AkazeX/GEM/999_Präsentation/Bilder v. präsentation/10a-5-25v--dual-channel-dc-motor-driver-5-large.jpg

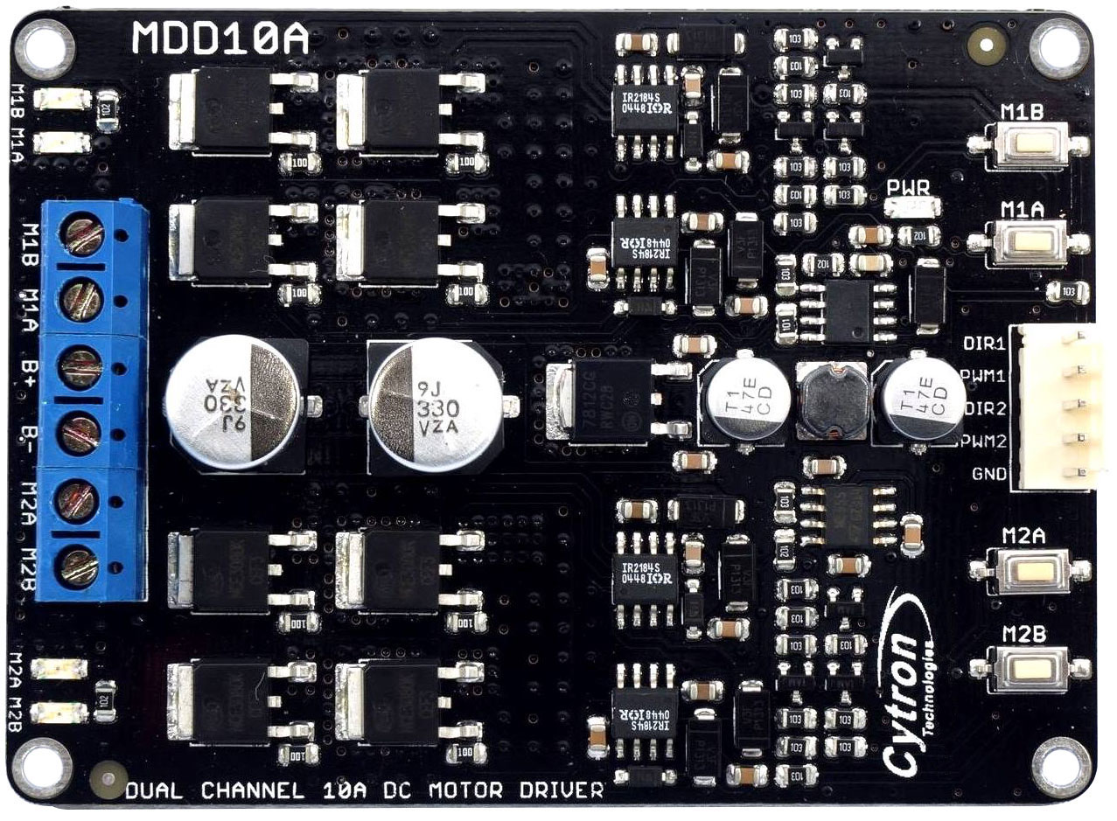
999_Präsentation/Bilder v. präsentation/10a-5-25v--dual-channel-dc-motor-driver-5-large.jpg
