AkazeX/GEM/999_Präsentation/Bilder v. präsentation/Display.jpg

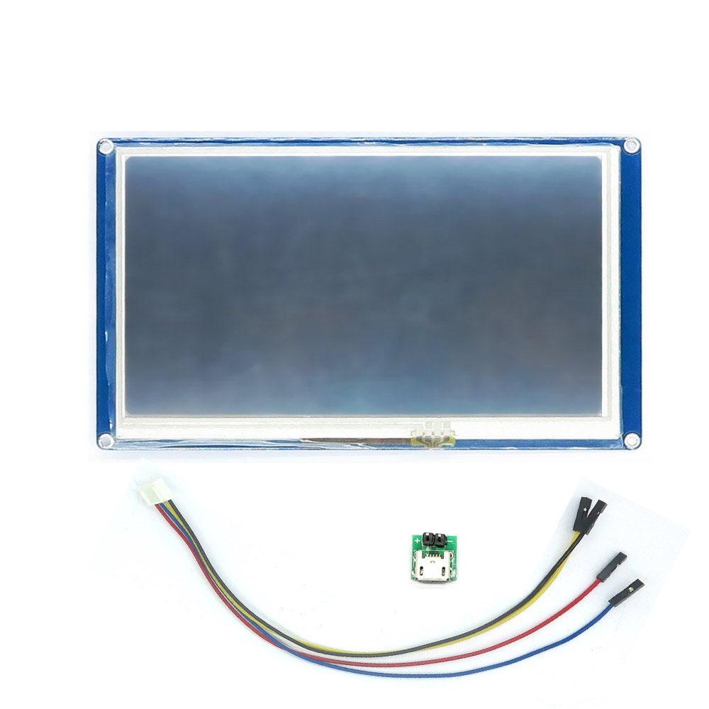
999_Präsentation/Bilder v. präsentation/Display.jpg
