AkazeX/GEM/Plakat 2.docx

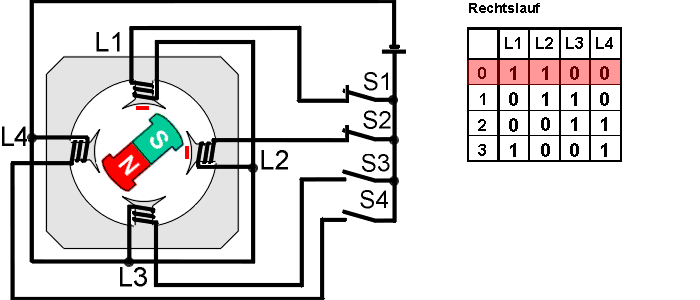
[picture p3: figure]
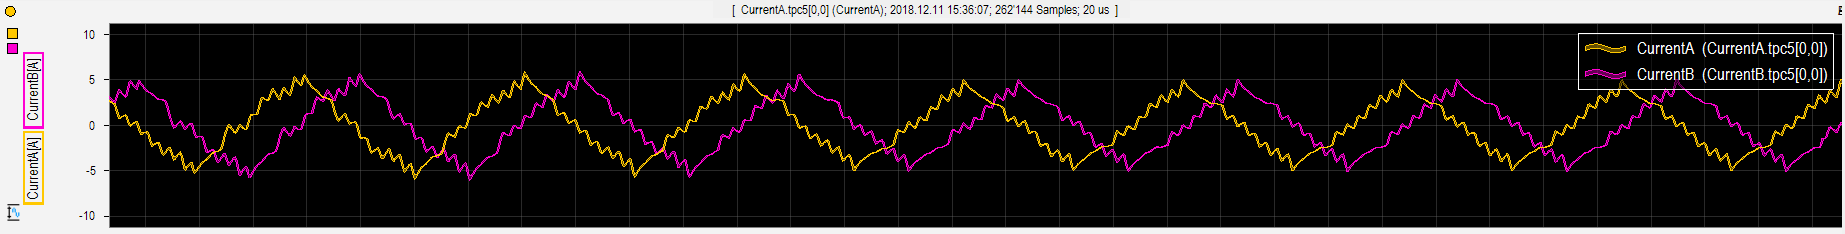
[picture p4: figure]
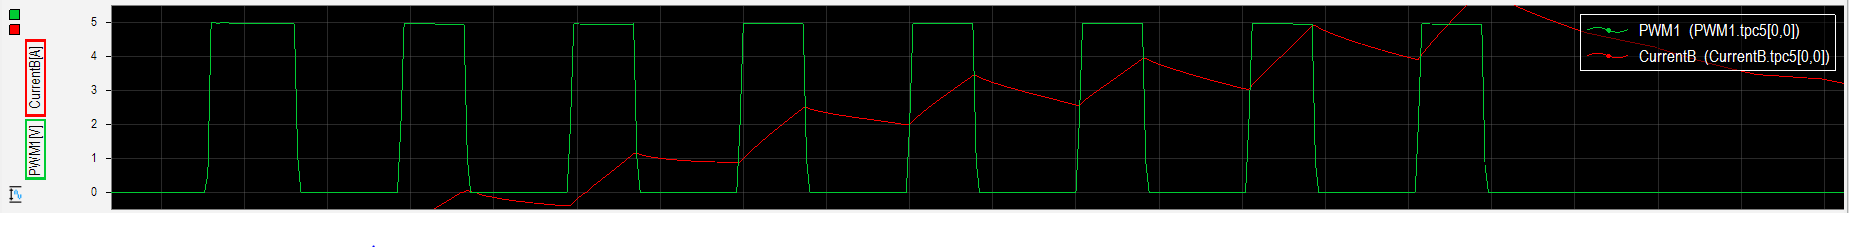
[picture p5: figure]

Ansteuerungsfolge Motor

Motorströme

PWM-Ansteuerung
