AkazeX/GEM/Plakat Software.docx

Getränke-Einschenk-Maschine

Grafcet

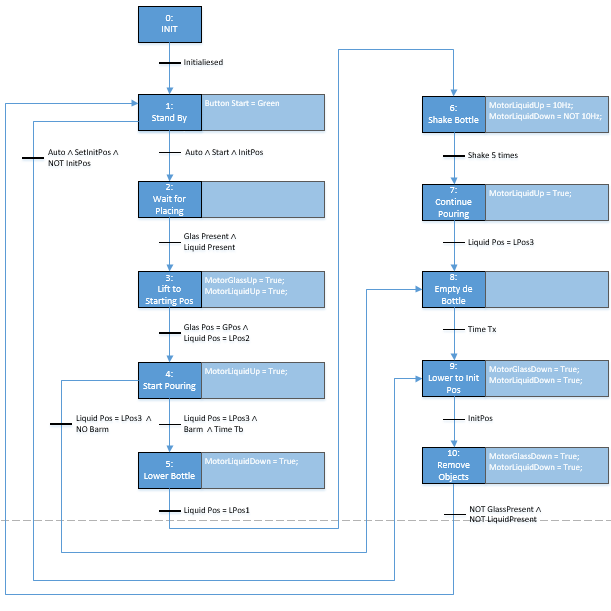
[picture p6: figure]

Display

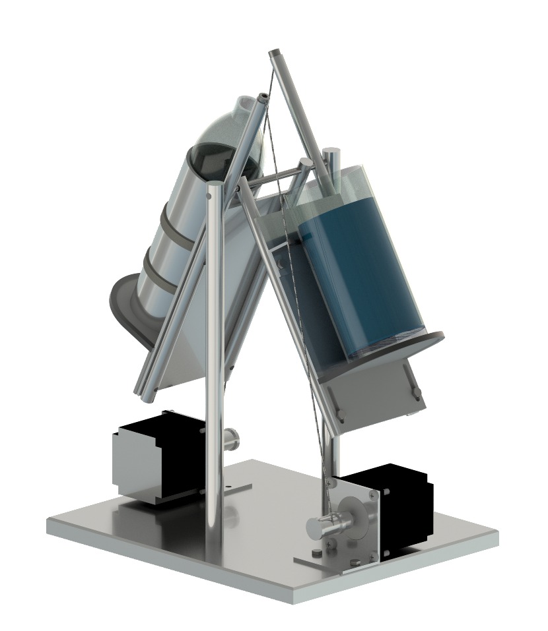
[picture p7: figure]
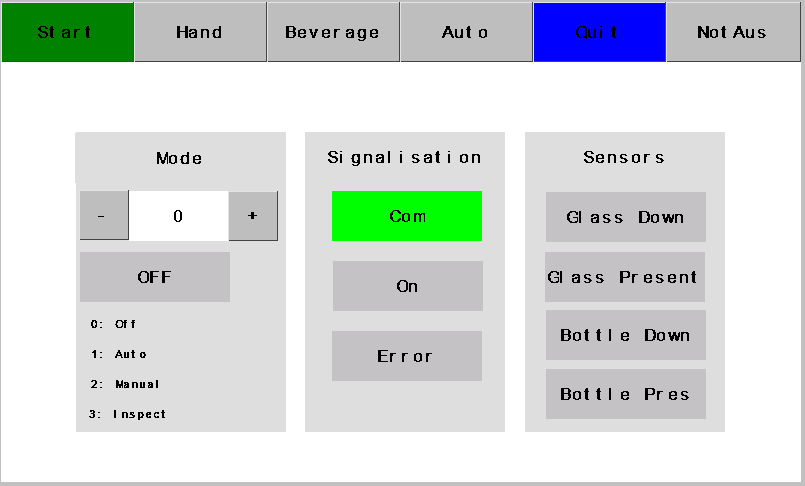
[picture p8: figure]
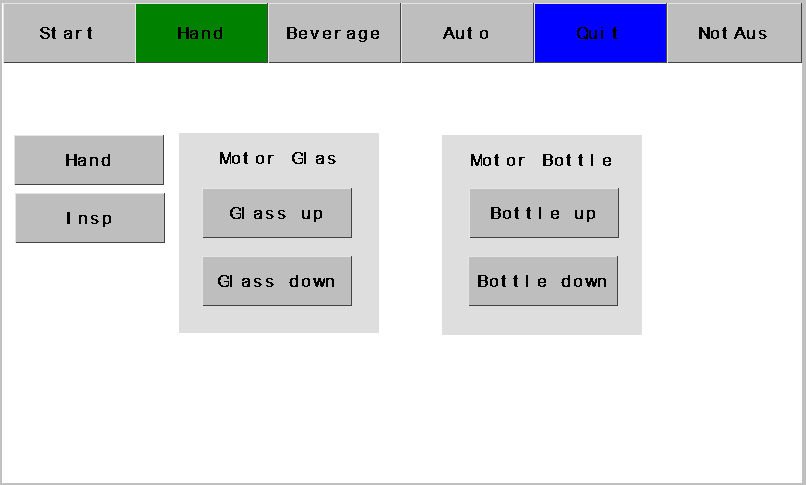
[picture p9: figure]
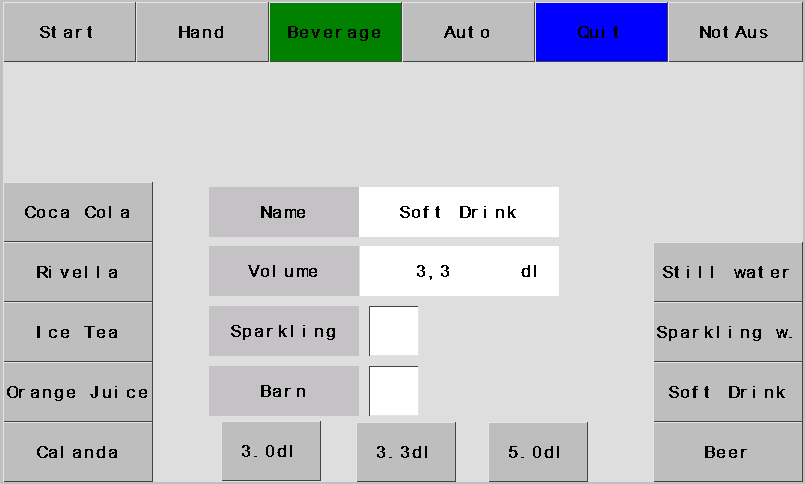
[picture p10: figure]

Kommunikation

Programm Ablauf

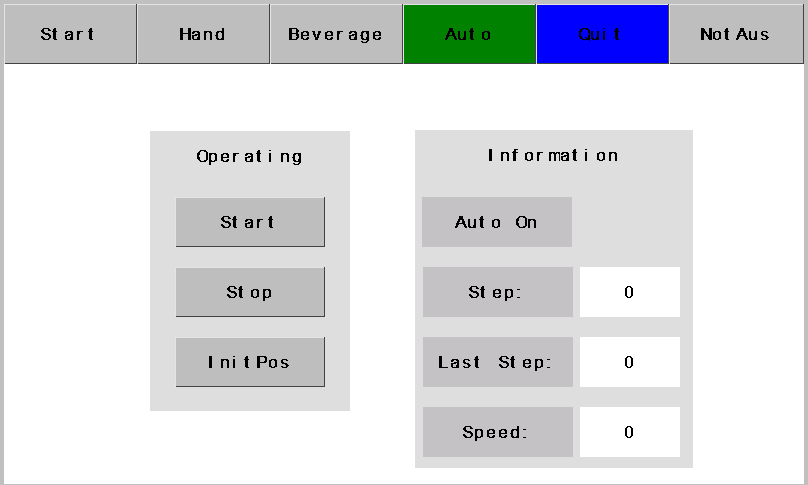
[picture p11: figure]
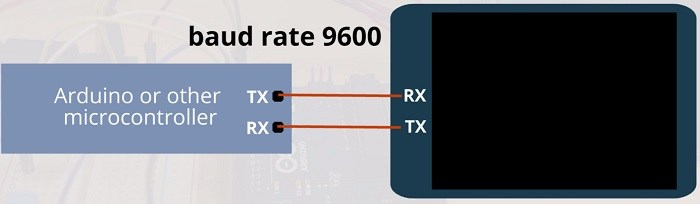
[picture p12: figure]
Image result for arduino zu nextion display
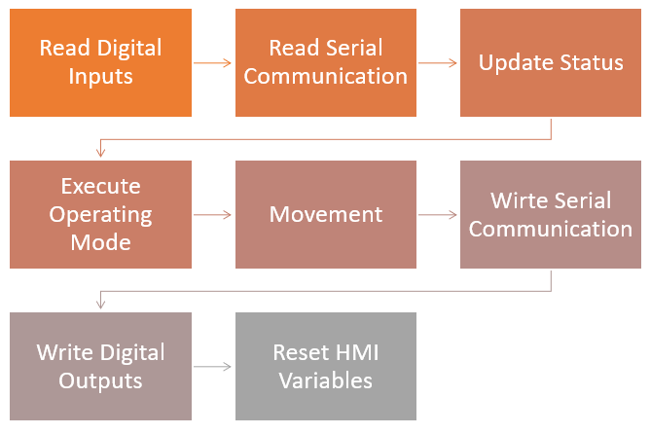
[picture p13: figure]
