AkazeX/GEM/40_Arbeitjournal/Arbeitsjournal_2018_10_31.docx

Namen: | Luca Schäfli, Nico Müller, Marc Hochuli | Datum: | 31.10.2018

Arbeit | Zeit (h)
Luca: - Start mit Programmstruktur - Einlesen in Arduino Umgebung - State machine / Grafcet | 2
Nico: - CAD zeichnen 50% | 2
Marc: - Start mit Programmstruktur - Einlesen in Arduino Umgebung | 2
Schwierigkeiten: - Kein

U:\AUT\Berufsbildung\Lernjournal\Lernjournal_xxx_KWYY_JJJJ.doc/Adrian Bärtschi/15.02.2010 Seite 2/2

\\swisslog.net\data-02\share-03\02_Realisation\02_Aut\Berufsbildung\99_Arbeitsunterlagen_mbr\IPA\Projektunterlagen\Arbeitsjournale\Arbeitsjournal_mbr_2018_Feb_26.docx/Marc Braun/28.11.2018 Seite 1/1

Lernjournal SWISSLOG
