AkazeX/GEM/10_Pflichtenheft/Links.rtf

Schrittmotoren:

https://www.distrelec.ch/de/schrittmotor-nm-65-mm-trinamic-qsh6018-65-28-210/p/15422354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

Motordriver Board:

https://www.robotshop.com/en/cytron-10a-5-30v-dual-channel-dc-motor-driver.html

Arduino:

https://www.distrelec.ch/de/microcontroller-board-mega2560-r3-arduino-a000067/p/11038920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
