AkazeX/GEM/999_Präsentation/PPP/GEM.pptx

## GEM

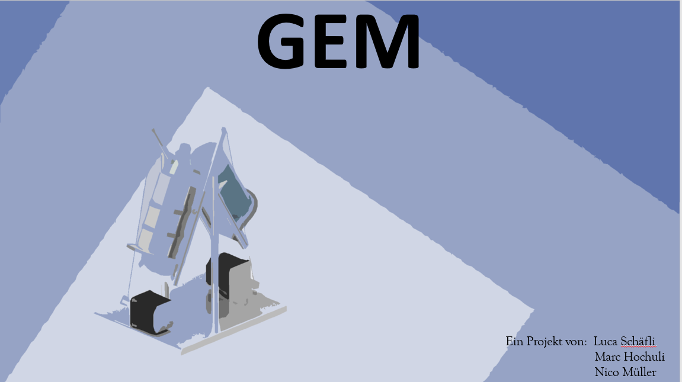
[picture p29: figure]

Ein Projekt von: Luca Schäfli
Marc Hochuli
Nico Müller

Notes: Ein Projekt von: Luca Schäfli
Marc Hochuli
Nico Müller

## Content

- Timetable
- CAD and mechanical components
- Schematics and electrical components
- Stepper motors
- Software
- Gem in Action
- Final statement

## Timetable

## CAD and mechanical components

## Schematics and electrical components

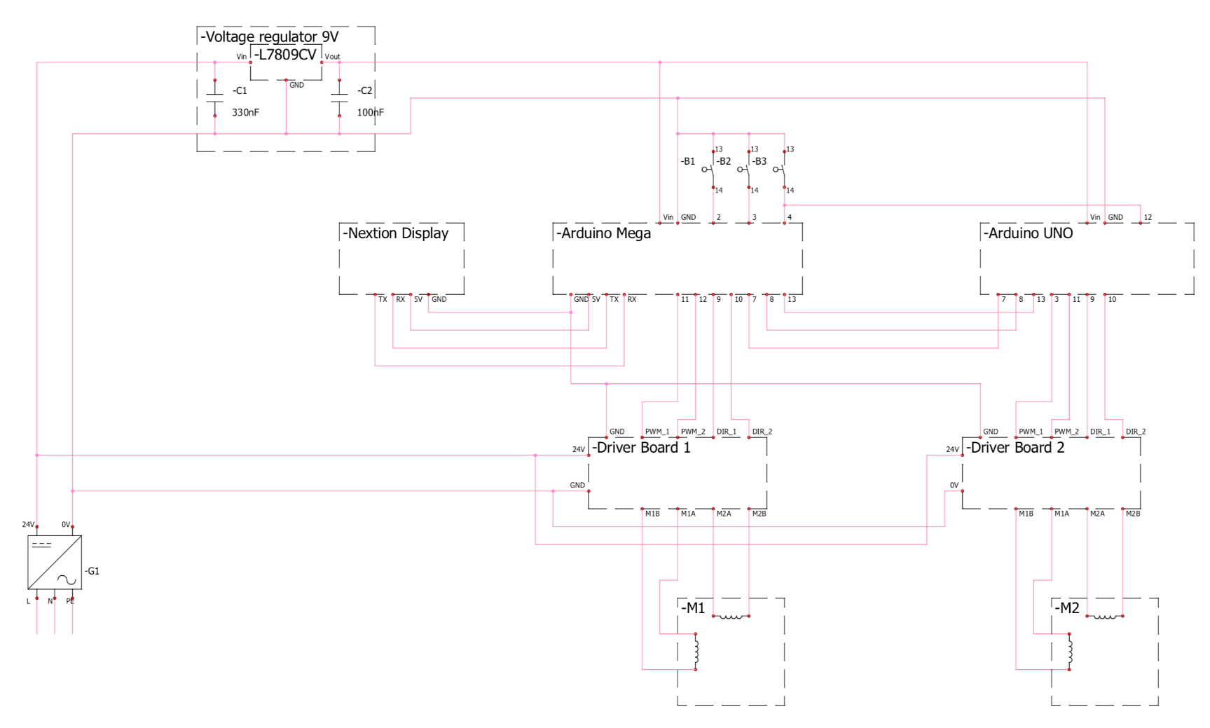
[picture p30: figure]

## Schematics and electrical components

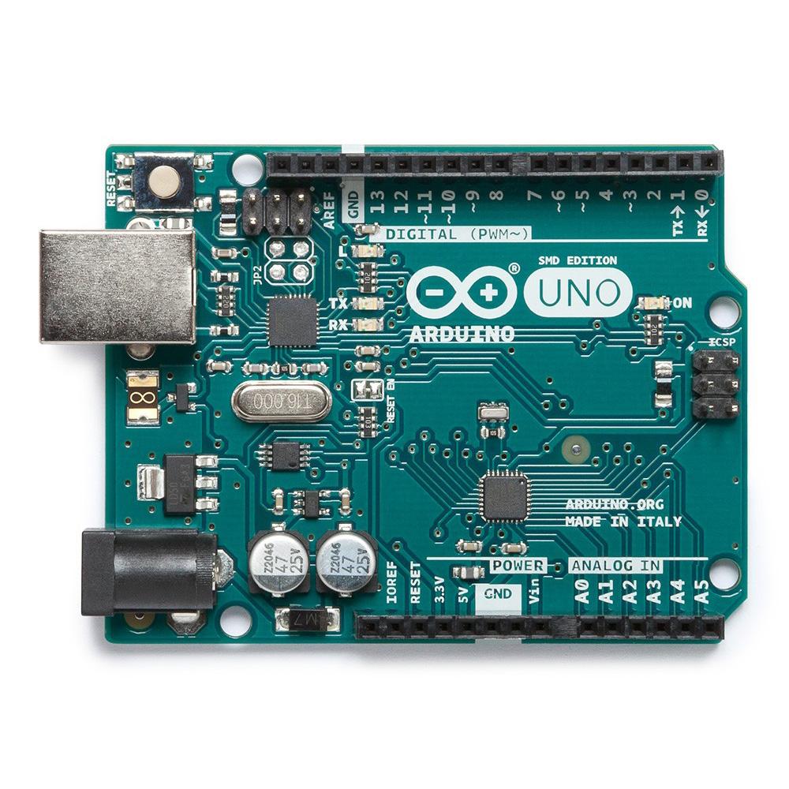
[picture p31: figure]
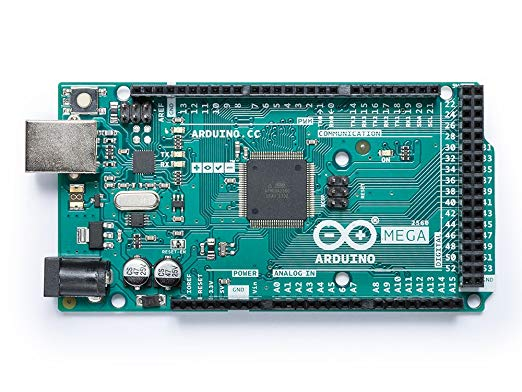
[picture p32: figure]
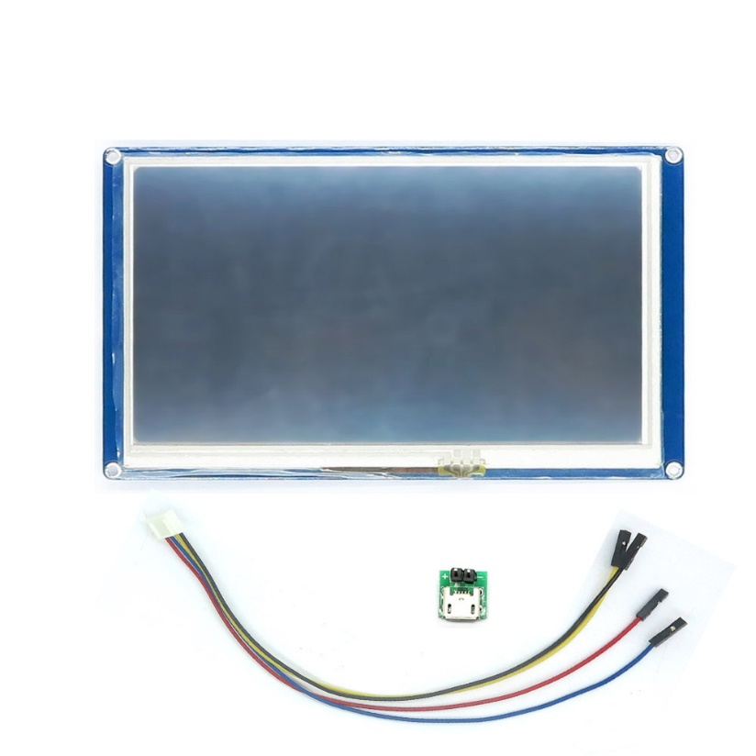
[picture p33: figure]

## Schematics and electrical components

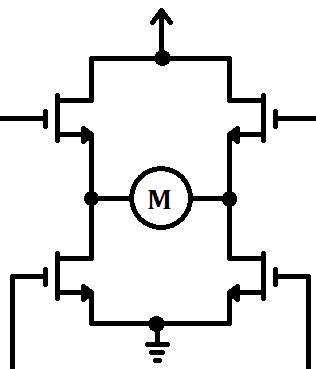
[picture p34: figure]

## Stepper motors

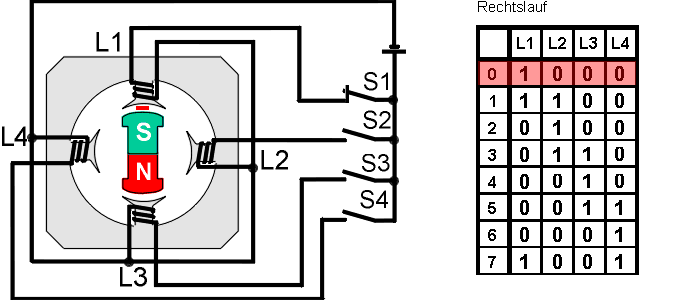
[picture p35: figure]
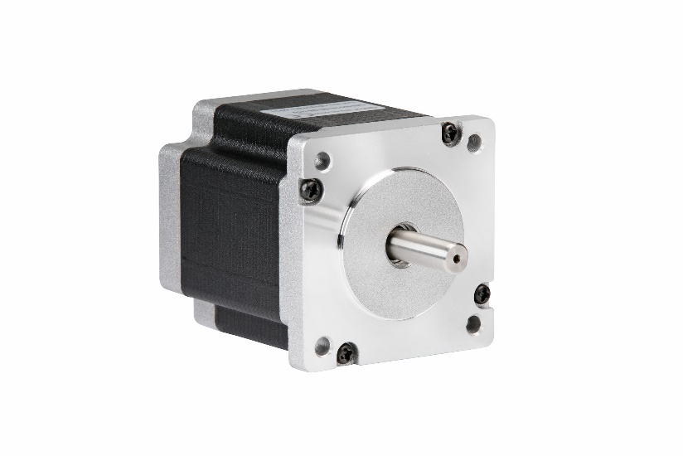
[picture p36: figure]

## Stepper motors

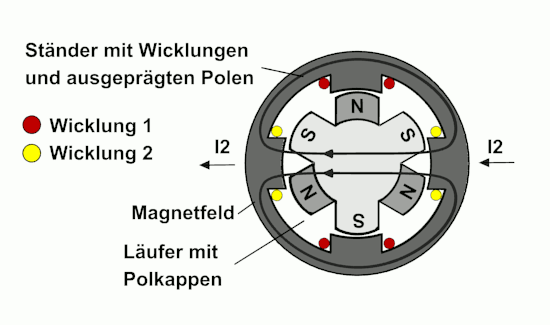
[picture p37: figure]

## Stepper motors

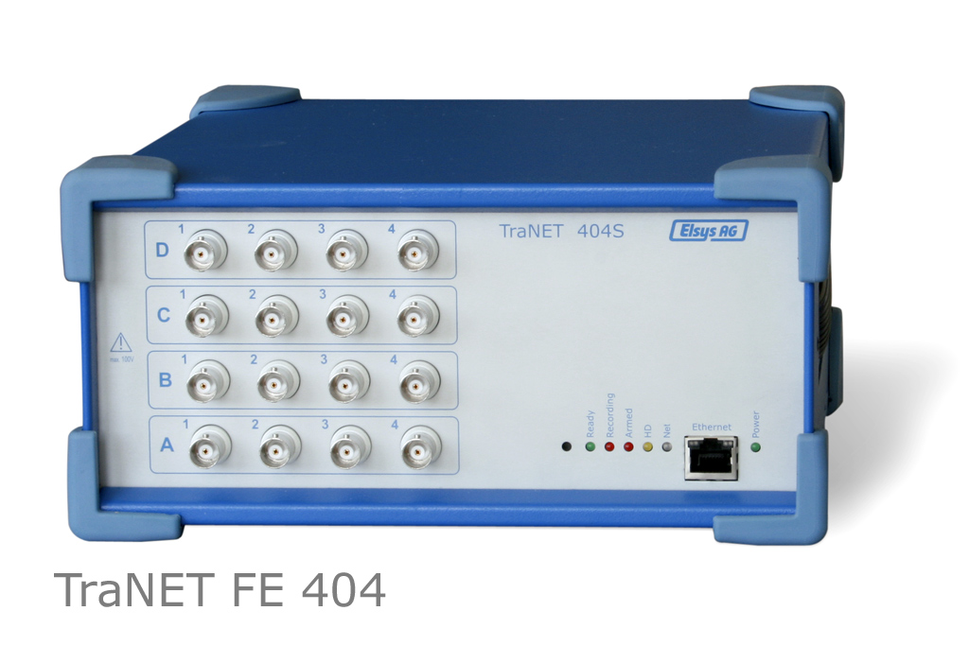
[picture p38: figure]

## Development Environment

- Arduino

- Variables Definition
- Keywords
- Void setup
- Void loop
- Statements
- {}

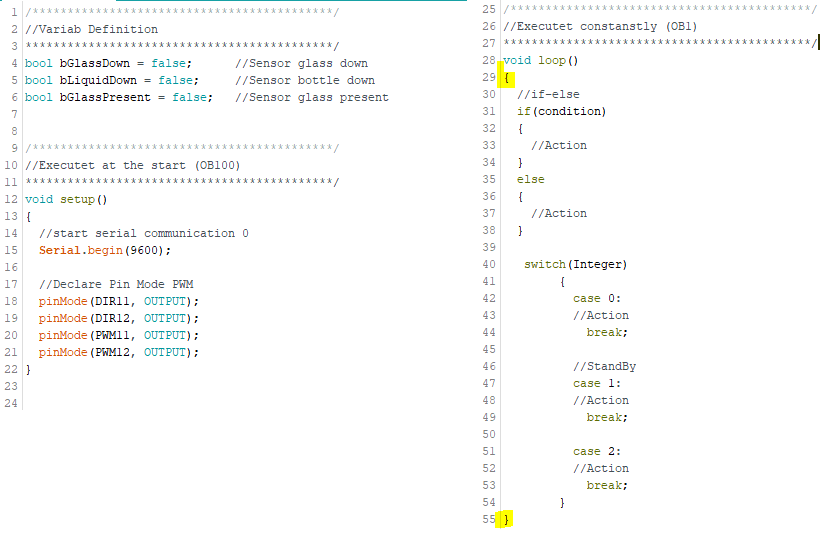
[picture p39: figure]

## Development Environment

Nextion Editor

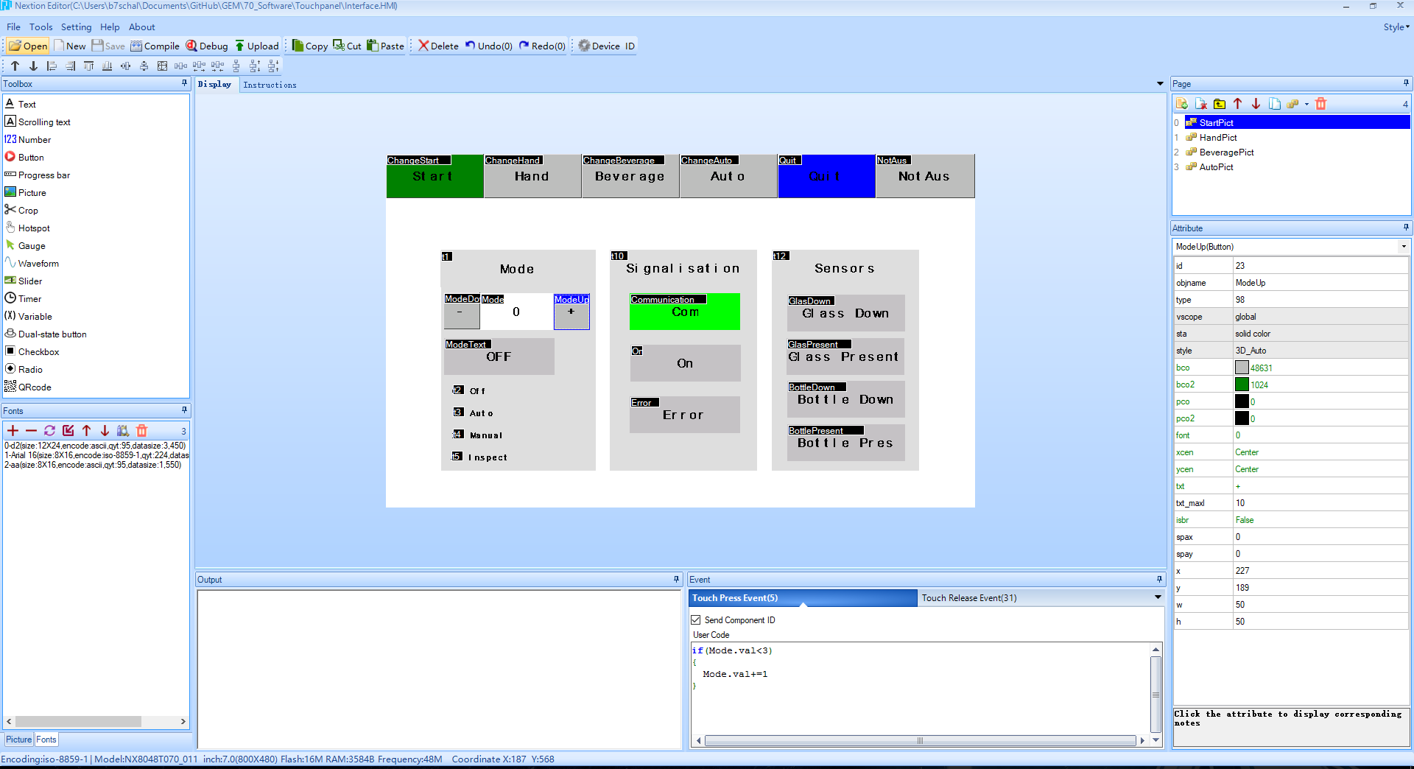
[picture p40: figure]

## Software - Structure

Read Digital Inputs
Read Serial Communication
Update Status
Execute Operating Mode
Movement
Wirte Serial Communication
Write Digital Outputs
Reset HMI Variables

## Software - Operating Modes

Operating Mode
Off
Auto
Hand
Insp

## Software – Grafcet

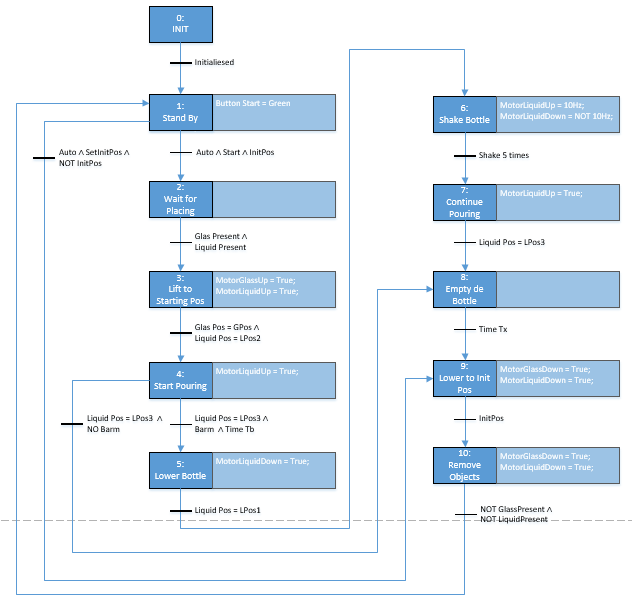
[picture p41: figure]
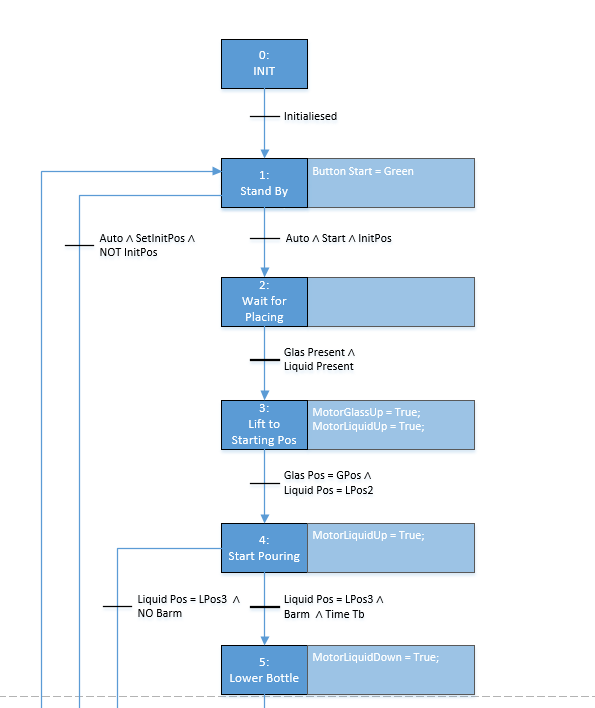
[picture p42: figure]
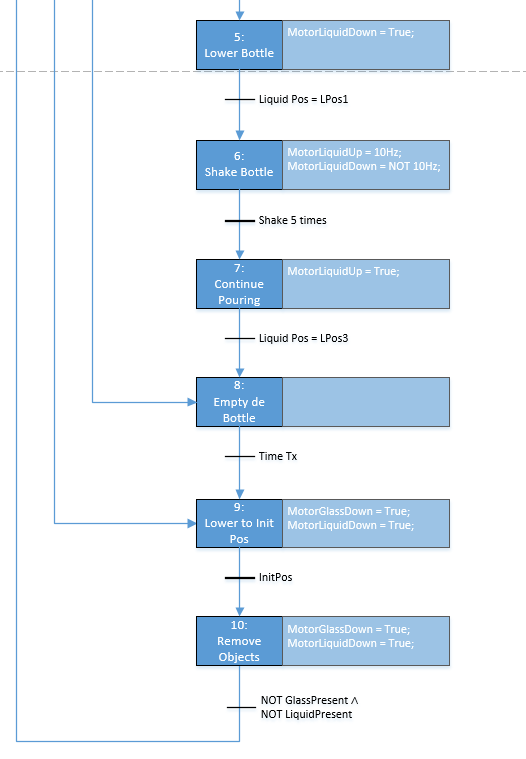
[picture p43: figure]

## Software - HMI


## Software - Communication

- Arduino Mega Serial Ports
- Tx / Rx
- Serial Monitor
- Serial.println(variable);

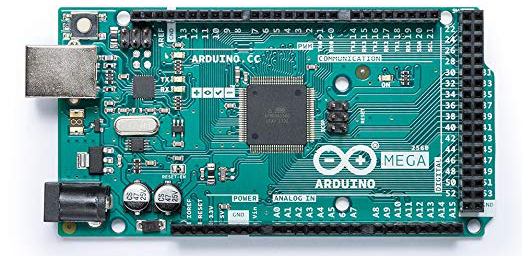
[picture p44: figure]
Image result for arduino mega
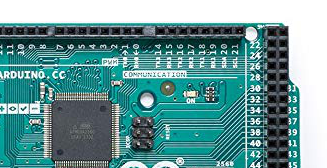
[picture p45: figure]
Image result for arduino mega
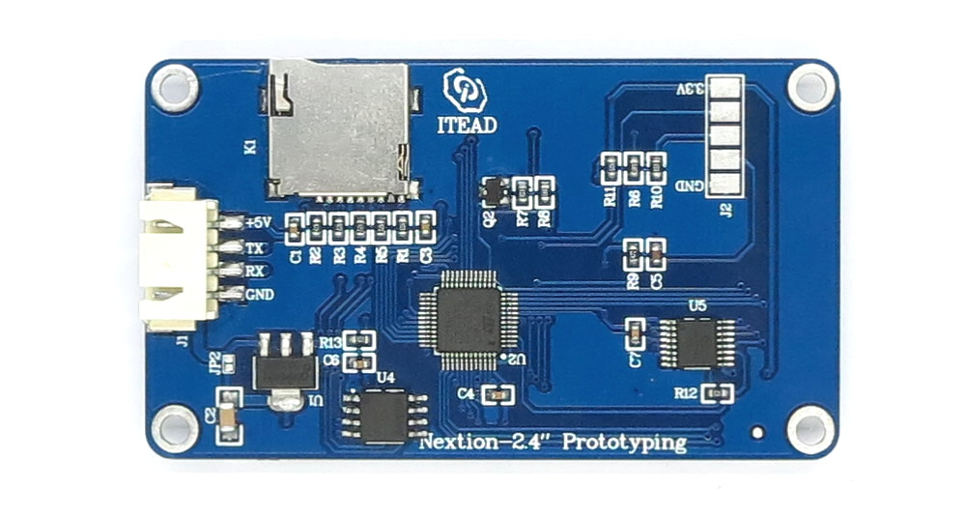
[picture p46: figure]

## Software - Communication

65 02 16 01 FF FF FF
- 65: Starting Sequence
- 02: Page number
- 16: Object ID
- 01: State of the pushbutton
- FF: End Sequence

## Abbildungsverzeichnis

- Arduino Mega: https://images-na.ssl-images-amazon.com/images/I/71WYcNLIVpL._SX522_.jpg
- Nextion HMI: https://cdn.itead.cc/media/catalog/product/i/m/im150416002_3.jpg
