AkazeX/GEM/999_Präsentation/PPP/luca.pptx

## GEM


Ein Projekt von: Luca Schäfli
Marc Hochuli
Nico Müller

Notes: Ein Projekt von: Luca Schäfli
Marc Hochuli
Nico Müller

## Content

- Timetable
- CAD and mechanical components
- Schematics and electrical components
- Stepper motors
- Software
- Gem in Action
- Final statement

## Timetable

## CAD and mechanical components

## Schematics and electrical components


## Schematics and electrical components


## Schematics and electrical components


## Stepper motors


## Stepper motors


## Stepper motors


## Development Environment

- Arduino

- Variables Definition
- Keywords
- Void setup
- Void loop
- Statements
- {}


## Development Environment

Nextion Editor


## Software - Structure

Read Digital Inputs
Read Serial Communication
Update Status
Execute Operating Mode
Movement
Wirte Serial Communication
Write Digital Outputs
Reset HMI Variables

## Software - Operating Modes

Operating Mode
Off
Auto
Hand
Insp

## Software – Grafcet


## Software - HMI


## Software - Communication

- Arduino Mega Serial Ports
- Tx / Rx
- Serial Monitor
- Serial.println(variable);

Image result for arduino mega
Image result for arduino mega

## Software - Communication

65 02 16 01 FF FF FF
- 65: Starting Sequence
- 02: Page number
- 16: Object ID
- 01: State of the pushbutton
- FF: End Sequence

## Abbildungsverzeichnis

- Arduino Mega: https://images-na.ssl-images-amazon.com/images/I/71WYcNLIVpL._SX522_.jpg
- Nextion HMI: https://cdn.itead.cc/media/catalog/product/i/m/im150416002_3.jpg
