AkazeX/GEM/50_Dokumentation/Abgabe/Anhang/10.Literaturhinweise/Qullen.docx

Literaturverzeichnis:

Für die Dokumentation wurden keine Literaturquellen benützt.

Abbildungsverzeichnis:

Abb.13 Treiberboard: https://www.robotshop.com/media/files/images2/10a-5-25v--dual-channel-dc-motor-driver-5-large.jpg

Alle anderen Bilder entstanden während der Produktion und sind selbst gemacht.

Hilfsmittel:

Folgende Seiten haben uns geholfen beim Programmieren.

Arduino: https://www.arduino.cc/reference/en/

Nextion: https://nextion.itead.cc/resources/documents/instruction-set/
