AkazeX/GEM/40_Arbeitjournal/Arbeitsjournal_2018_12_05.docx

Namen: | Luca Schäfli, Nico Müller, Marc Hochuli | Datum: | 05.12.2018

Arbeit | Zeit (h)
Luca: - Programm weiter gemacht - Checkliste gestartet - Dokumentation gestartet | 2
Nico: - Mit mechanischer Fertigung begonnen | 2
Marc: - Motor Ansteuerung programmiert | 2
Schwierigkeiten: - Kein

U:\AUT\Berufsbildung\Lernjournal\Lernjournal_xxx_KWYY_JJJJ.doc/Adrian Bärtschi/15.02.2010 Seite 2/2

\\swisslog.net\data-02\share-03\02_Realisation\02_Aut\Berufsbildung\99_Arbeitsunterlagen_mbr\IPA\Projektunterlagen\Arbeitsjournale\Arbeitsjournal_mbr_2018_Feb_26.docx/Marc Braun/05.12.2018 Seite 1/1

Lernjournal SWISSLOG
