AkazeX/GEM/60_Hardware/Schema/Schema_GEM_Hand.pdf

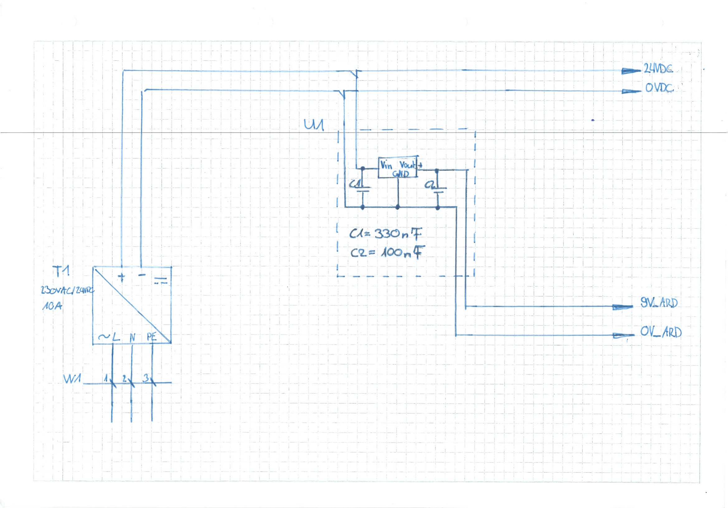
[picture p49: page 1]
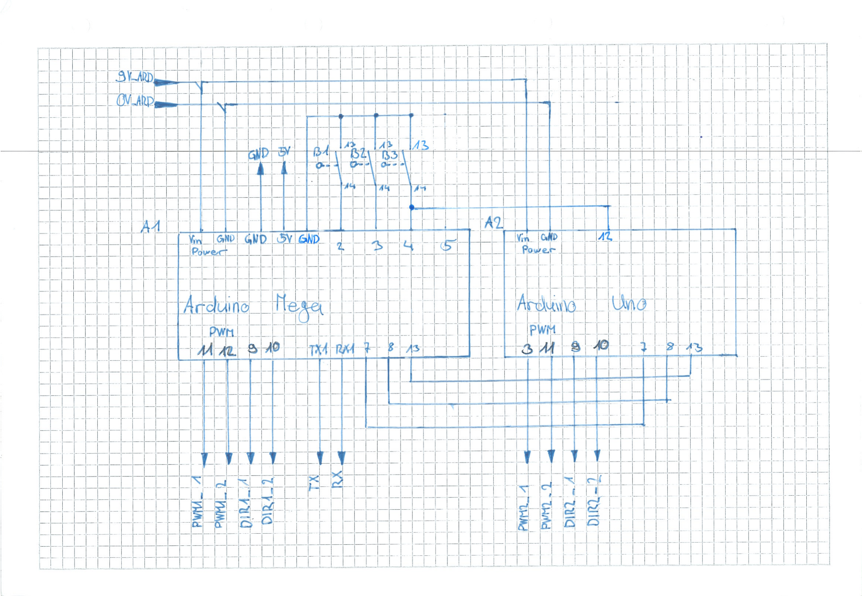
[picture p50: page 2]
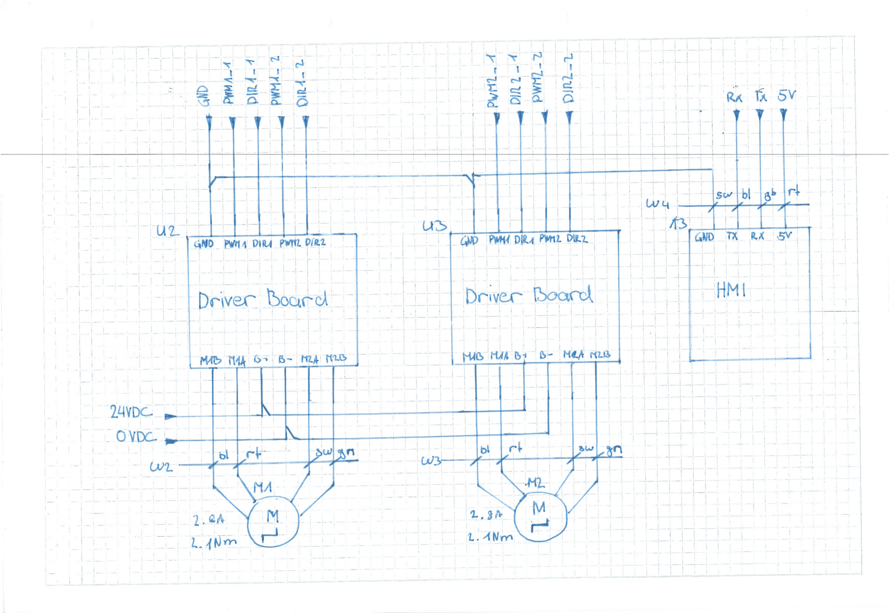
[picture p51: page 3]
