AkazeX/GEM/50_Dokumentation/Abgabe/Anhang/8.Kostenberechnung/RechnungNr1.pdf

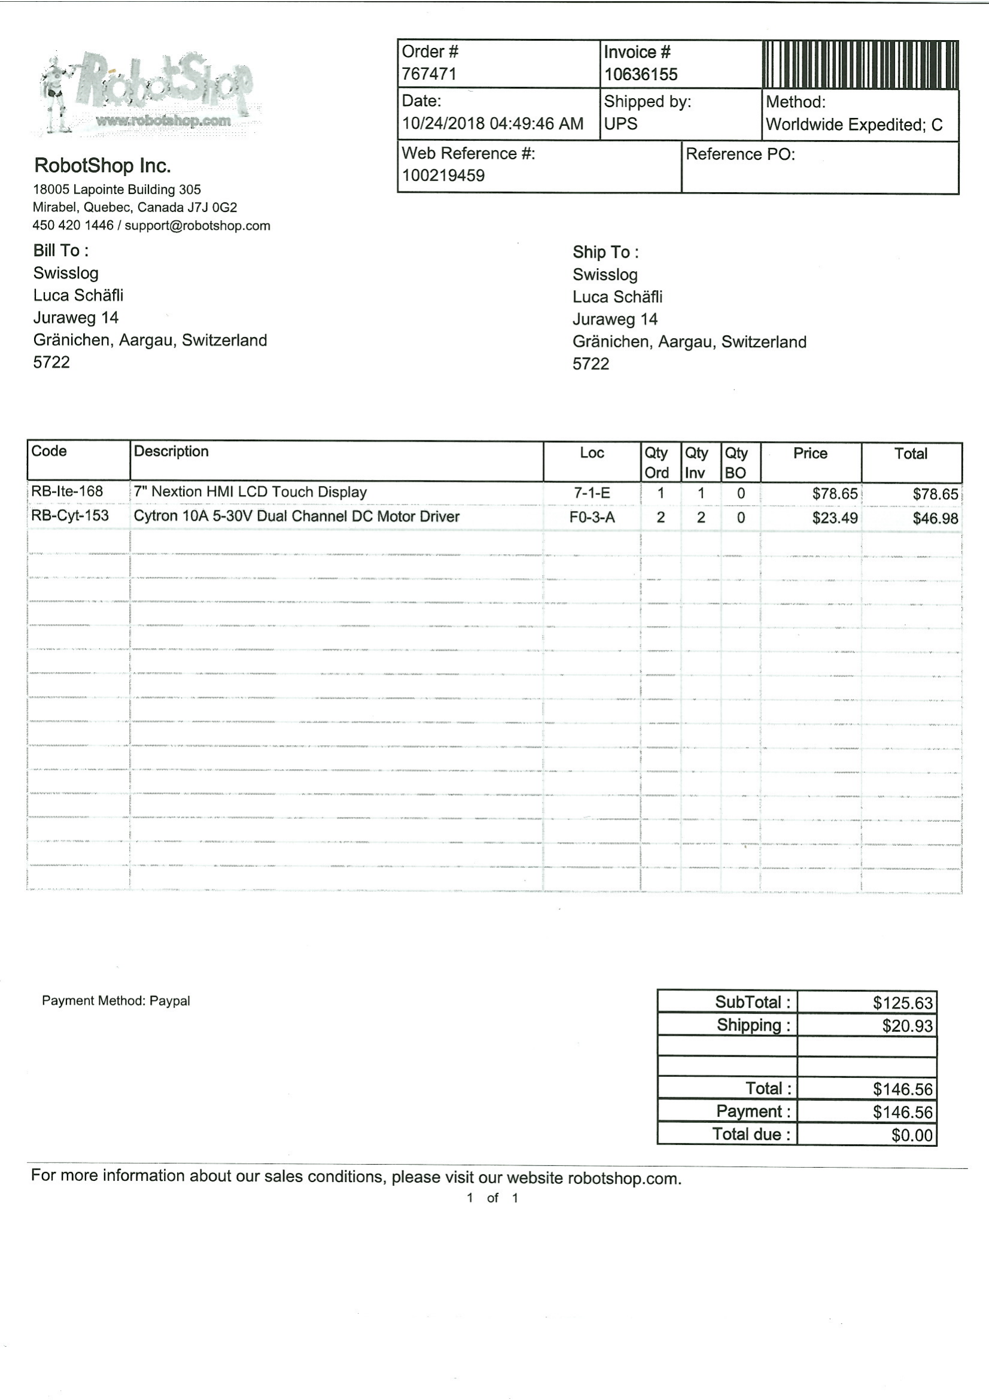
[picture p52: page 1]
