AkazeX/GEM/999_Präsentation/PPP/old/GEM.pptx

## GEM

Ein Projekt von: Luca Schäfli
Marc Hochuli
Nico Müller

Notes: Ein Projekt von: Luca Schäfli
Marc Hochuli
Nico Müller

## Content

- Timetable
- CAD and mechanical components
- Schematics and electrical components
- Stepper motors
- Development environment
- Operating modes
- State machine
- Final statement

## Timetable

## CAD and mechanical components

## Schematics and electrical components

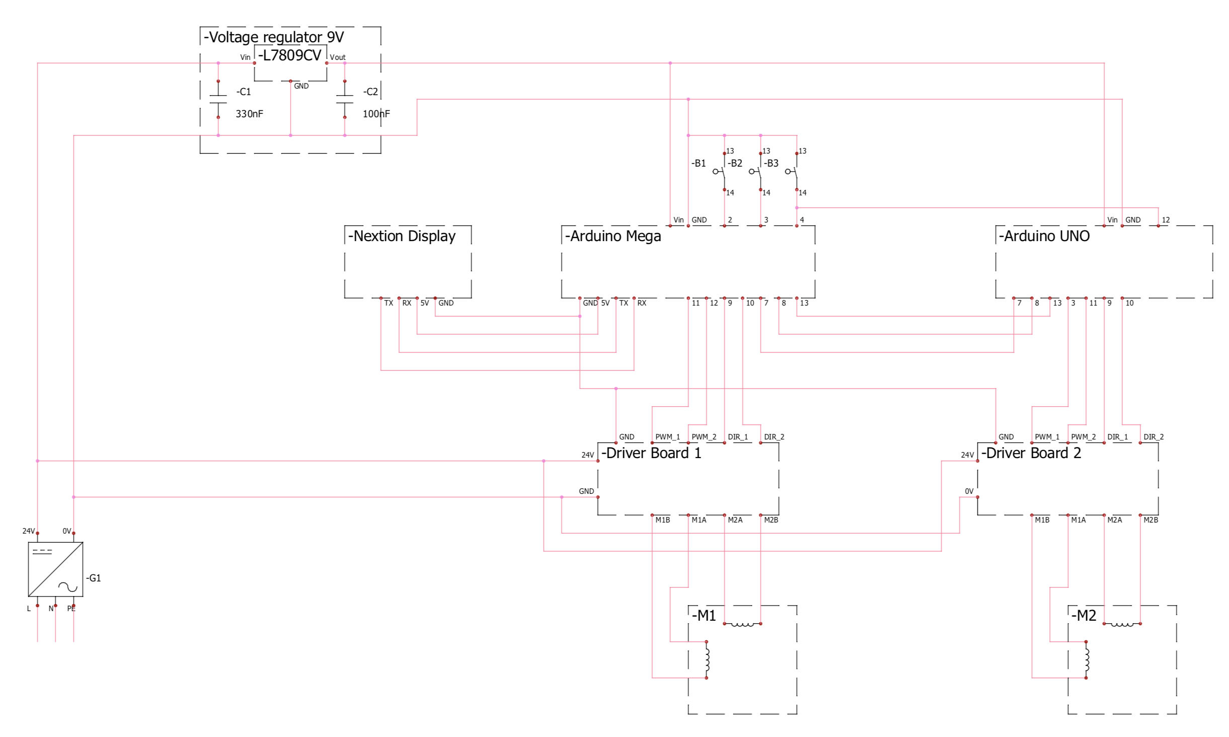
[picture p53: figure]

## Schematics and electrical components


## Schematics and electrical components


## Stepper motors

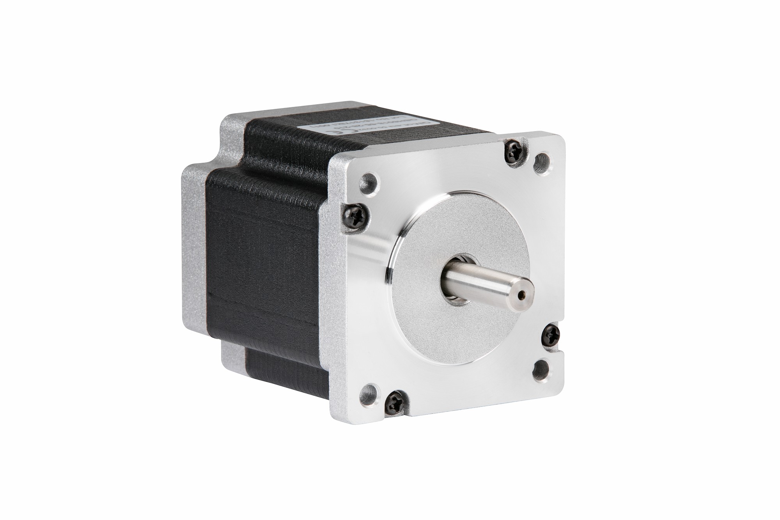
[picture p54: figure]

## Stepper motors


## Stepper motors


## Development Environment

- Nextion Editor

- Variables Definition
- Keywords
- Void setup
- Void loop
- Statements
- {}

- Arduino


## Development Environment

- Nextion Editor


## Operating Mode

- Off
- Auto
- Hand
- Insp

## State Machine


## Final statement
