AkazeX/GEM/60_Hardware/Schema/_old/Schema_GEM_old2.pdf

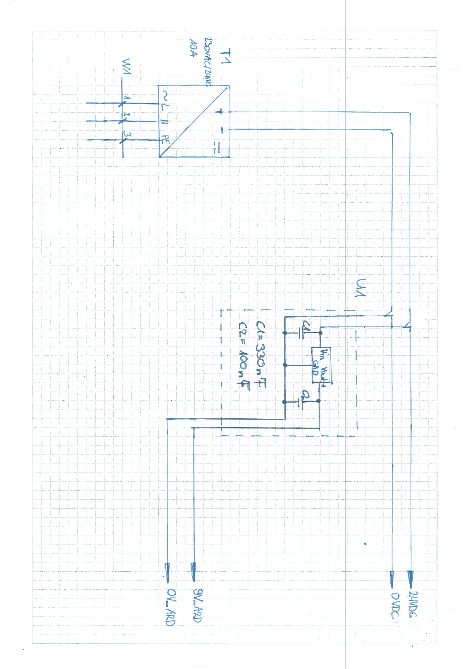
[picture p55: page 1]
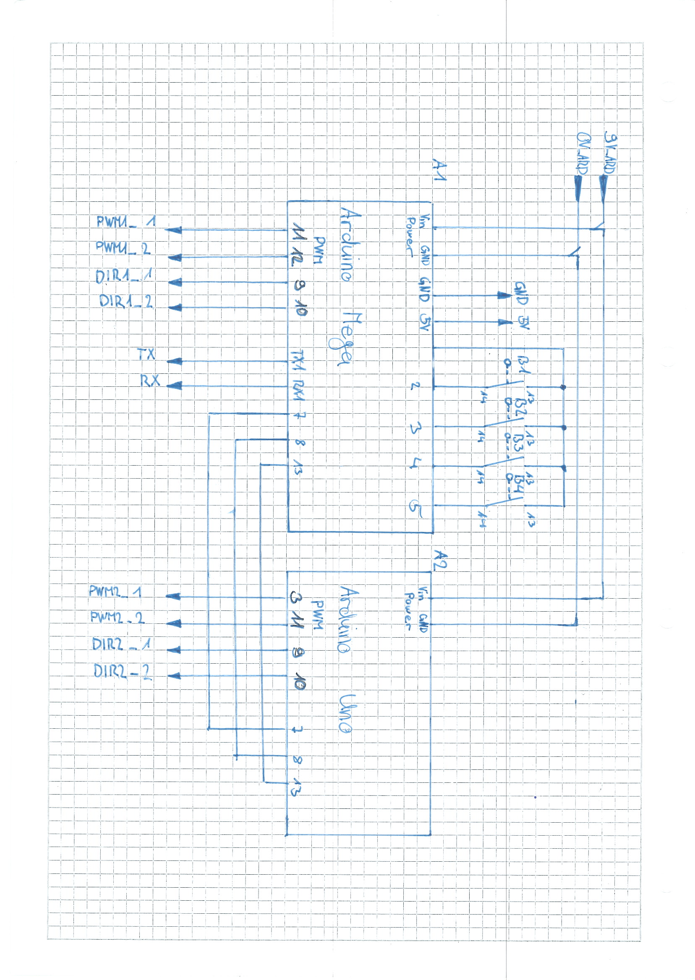
[picture p56: page 2]
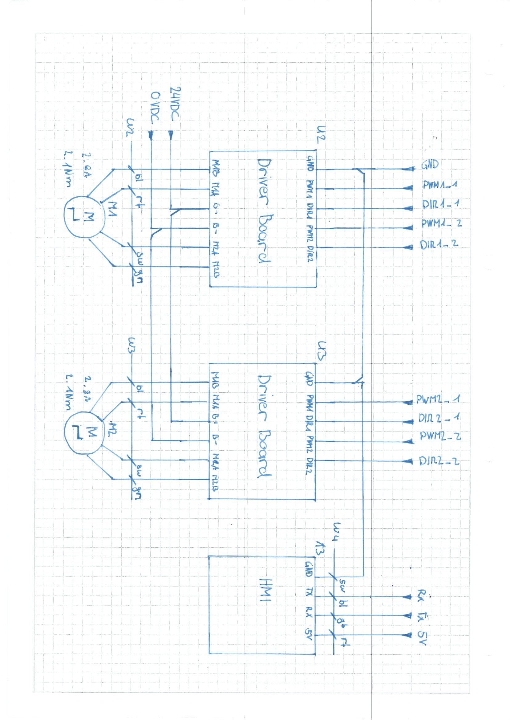
[picture p57: page 3]
