AkazeX/GEM/60_Hardware/Schema/_old/Schema_GEM_old1.pdf

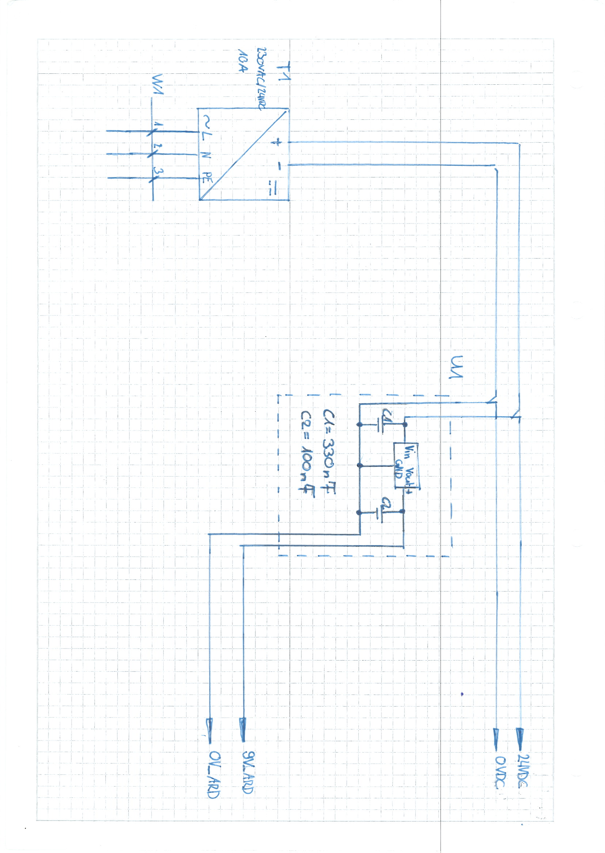
[picture p58: page 1]
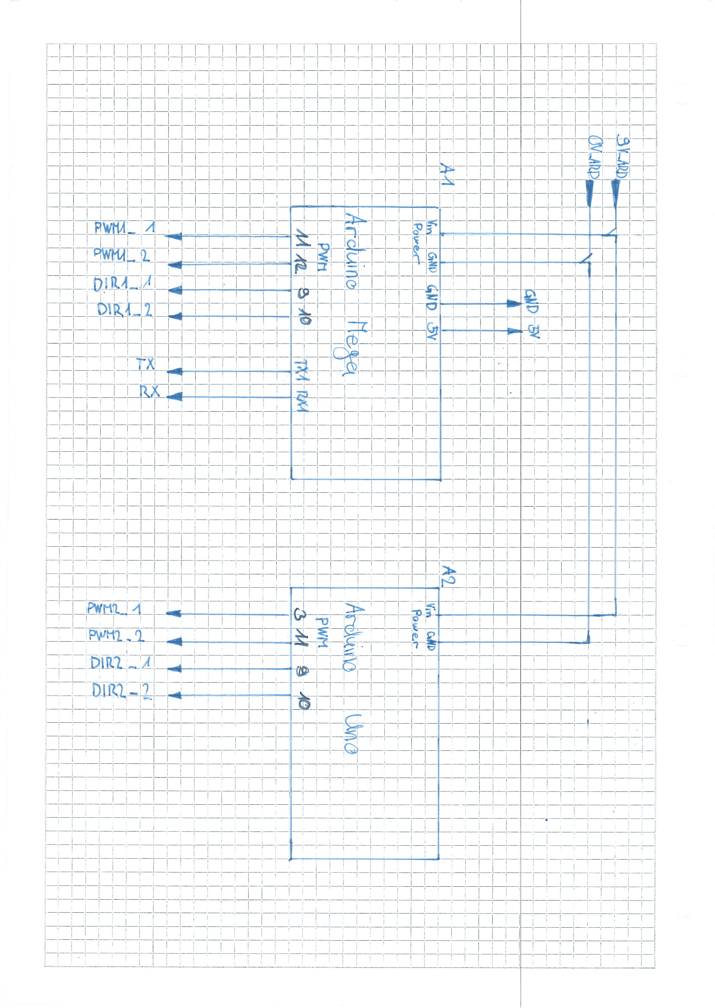
[picture p59: page 2]
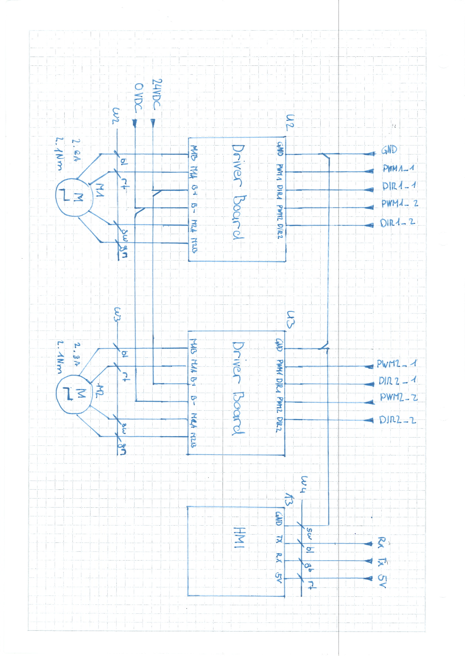
[picture p60: page 3]
