AkazeX/GEM/30_Rechnungen/distrelec.PNG

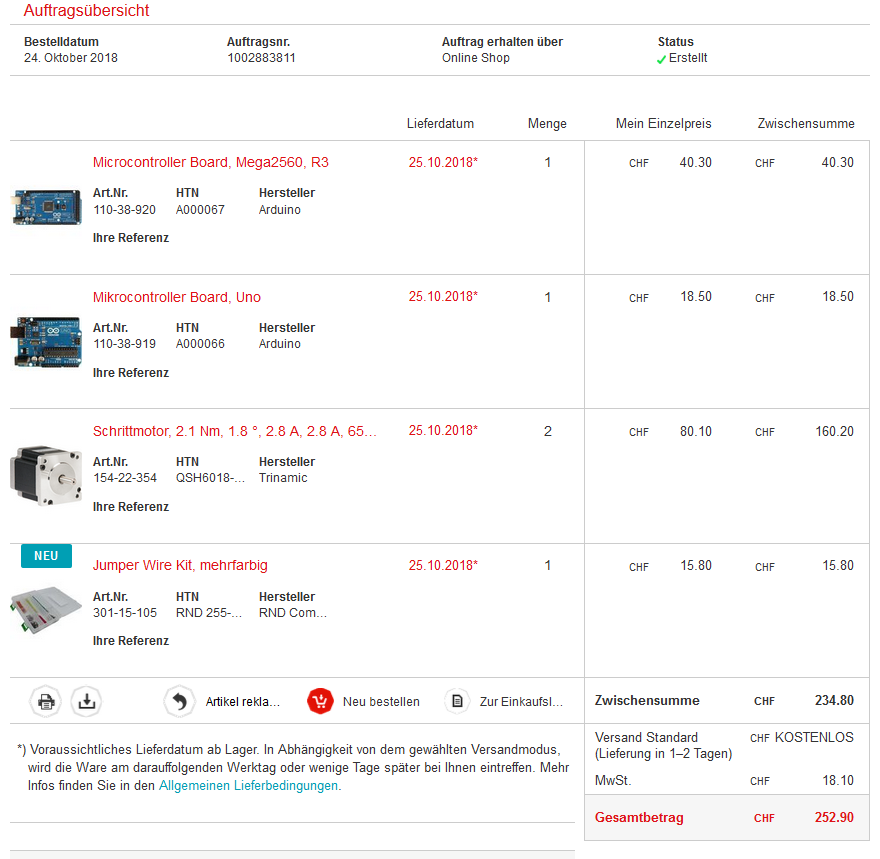
30_Rechnungen/distrelec.PNG
