AkazeX/GEM/50_Dokumentation/Abgabe/Anhang/8.Kostenberechnung/VisecaAuszug.PNG

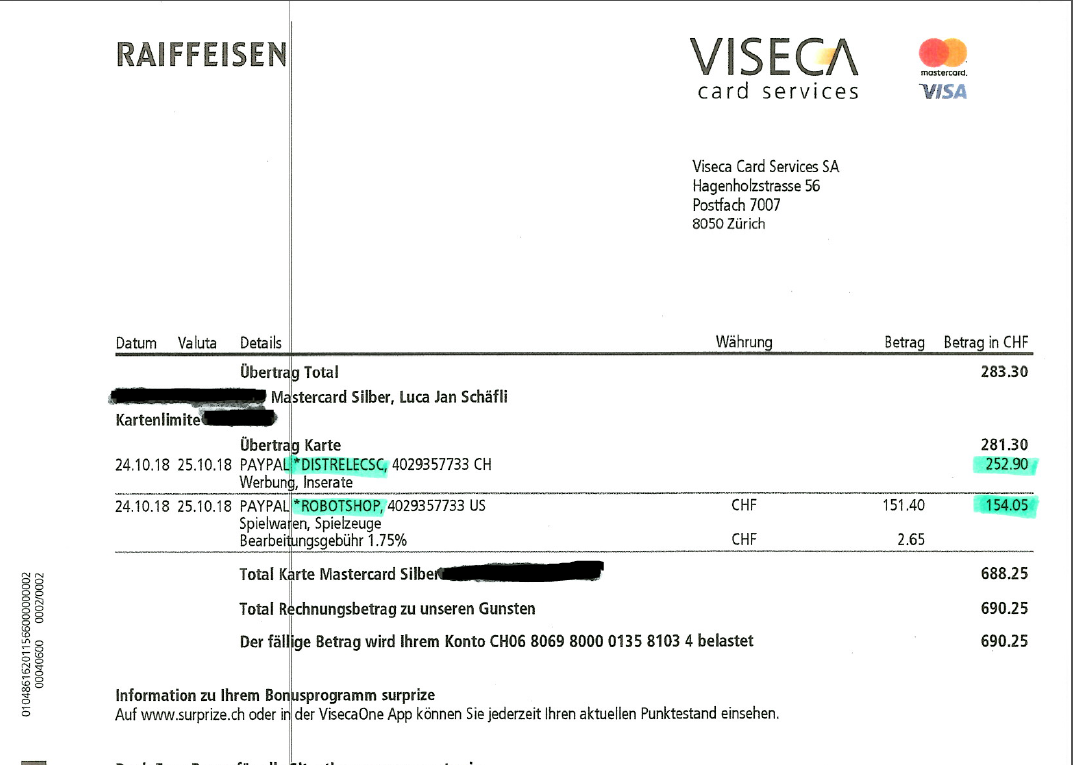
50_Dokumentation/Abgabe/Anhang/8.Kostenberechnung/VisecaAuszug.PNG
