AkazeX/GEM/50_Dokumentation/Bilder/Baugruppe;Render_2.png

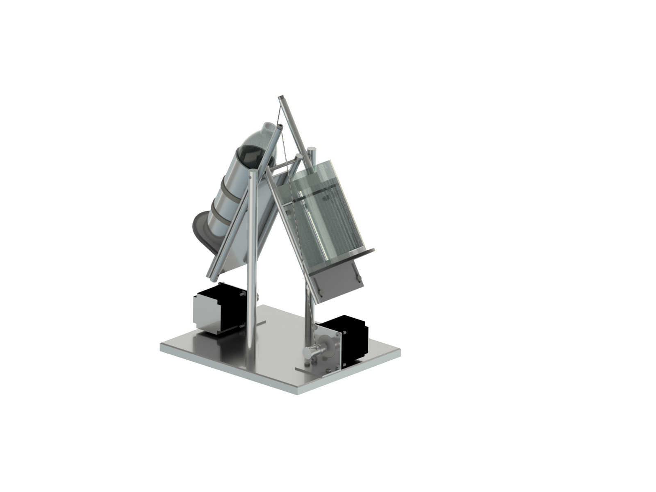
50_Dokumentation/Bilder/Baugruppe;Render_2.png
