AkazeX/GEM/50_Dokumentation/Bilder/Baugruppe;Render_3.png

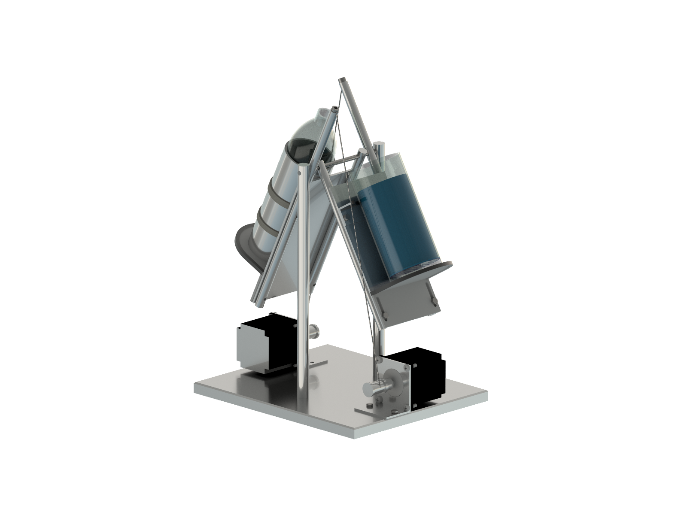
50_Dokumentation/Bilder/Baugruppe;Render_3.png
