AkazeX/GEM/50_Dokumentation/Bilder/Baugruppe;Render_4.png

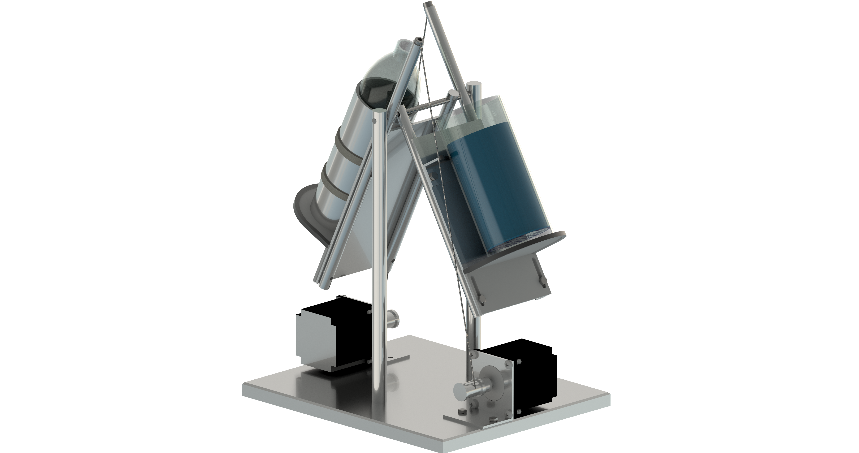
50_Dokumentation/Bilder/Baugruppe;Render_4.png
