AkazeX/GEM/50_Dokumentation/Bilder/Baugruppe;Render_5.png

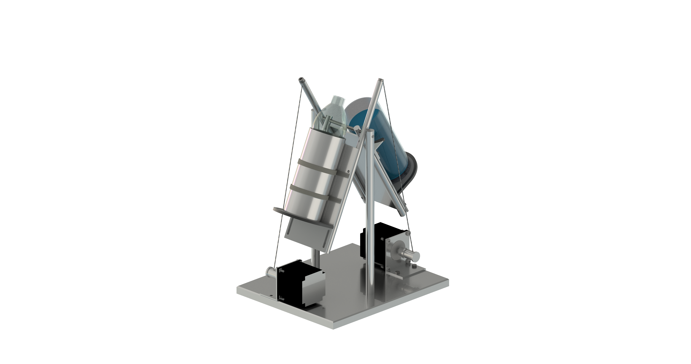
50_Dokumentation/Bilder/Baugruppe;Render_5.png
