AkazeX/GEM/50_Dokumentation/Bilder/Baugruppe;Render_6.png

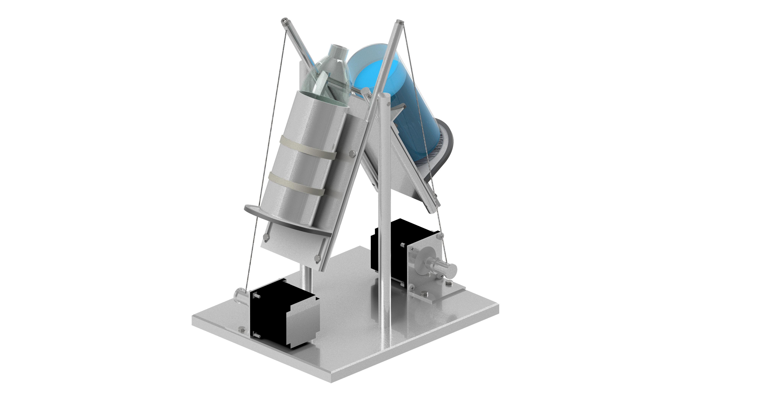
50_Dokumentation/Bilder/Baugruppe;Render_6.png
