AkazeX/GEM/50_Dokumentation/Abgabe/Anhang/6.Schemas Stücklisten/Stücklisten Schema.docx

Position | Artikel | Masse (länge/breite/höhe) in mm
1 | Arduino Mega | 60x120
2 | Netzgerät | 125x125
3 | Arduino Uno | 60x80
4 | Motoren Boards | 60x85
5 | Festspannungsregler | 30x45
6 | Display | 110x185
- | Gehäuse | 300/230/150

# Stückliste Schema
