AkazeX/GEM/70_Software/ObjectIDs.xlsx

StartPict (0) |  | HandPict (1) |  | BeveragePict (2) |  | AutoPict (3)
Name | ID | Name | ID | Name | ID | Name | ID
ChangeStart | 1 | ChangeStart | 1 | ChangeStart | 1 | ChangeStart | 1
ChangeHand | 2 | ChangeHand | 2 | ChangeHand | 2 | ChangeHand | 2
ChangeBeverage | 3 | ChangeBeverage | 3 | ChangeBeverage | 3 | ChangeBeverage | 3
ChangeAuto | 4 | ChangeAuto | 4 | ChangeAuto | 4 | ChangeAuto | 4
Mode | 20 | Motor1Up | 7 | Sparkling | 8 | AutStart | 7
Voltage | 13 | Motor1Down | 8 | Barn | 11 | AutStop | 8
On | 14 | Motor2Up | 11 | Cola | 14 | InitPos | 11
Error | 15 | Motor2Down | 12 | Rivella | 15 | Step | 15
GlasDown | 18 | Quit | 15 | Ice Tea | 16 | LastStep | 16
GlasPresent | 19 | NotAus | 16 | Osaft | 17 | Speed | 17
BottleDown | 21 |  |  | Calanda | 18 | Quit | 19
BottlePresent |  |  |  | StillWater | 19 | NotAus | 20
ModeUp | 22 |  |  | SpWater | 20
ModeDown | 23 |  |  | SoftDrink | 21
Quit | 24 |  |  | Beer | 22
NotAus | 25 |  |  | Quit | 12
 |  |  |  | NotAus | 13
