AkazeX/GEM/50_Dokumentation/Abgabe/Anhang/5.WerkstattskizzenStücklisten/Stückliste Gehäuse.docx

# Stückliste Gehäuse

Position | Artikel | Länge mm | Anzahl
1 | Tragschiene | 130 | 2
1 | Blechschrauben | 10 | 4
1 | U Scheiben | - | 4
2 | Tragschiene | 228 | 2
2 | Nutenstein M6 | - | 4
2 | Schrauben M6 | 10 | 4
3 | Winkel | Schema | 1
3 | Tragschiene | 65 | 1
3 | Blechschrauben | - | 1
3 | Schraube M5 | 12 | 1
3 | U Scheiben M5 | - | 2
3 | Mutter M5 | - | 1
4 | Nutenstein Ø4 | - | 8
4 | Schraube M3 | 18 | 8
4 | U Scheiben M3 | - | 16
4 | Muttern M3 | - | 8
- | Befestigungsstreifen | - | 1
- | Gehäuse | - | 1
