AkazeX/GEM/50_Dokumentation/Abgabe/Anhang/6.Schemas Stücklisten/Schema_GEM.pdf

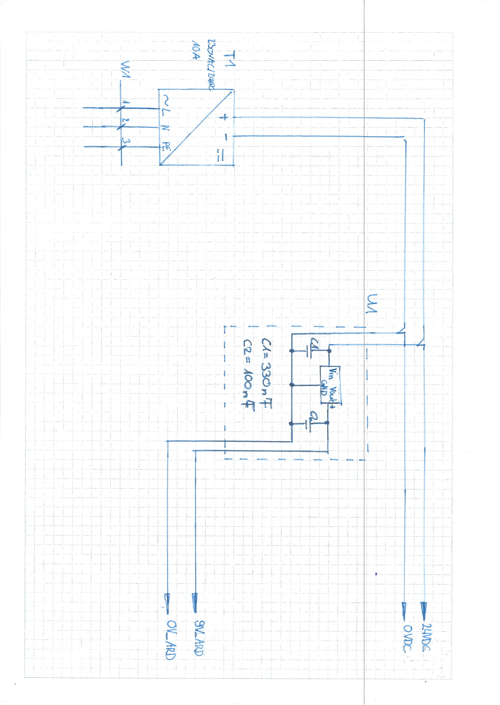
[picture p68: page 1]
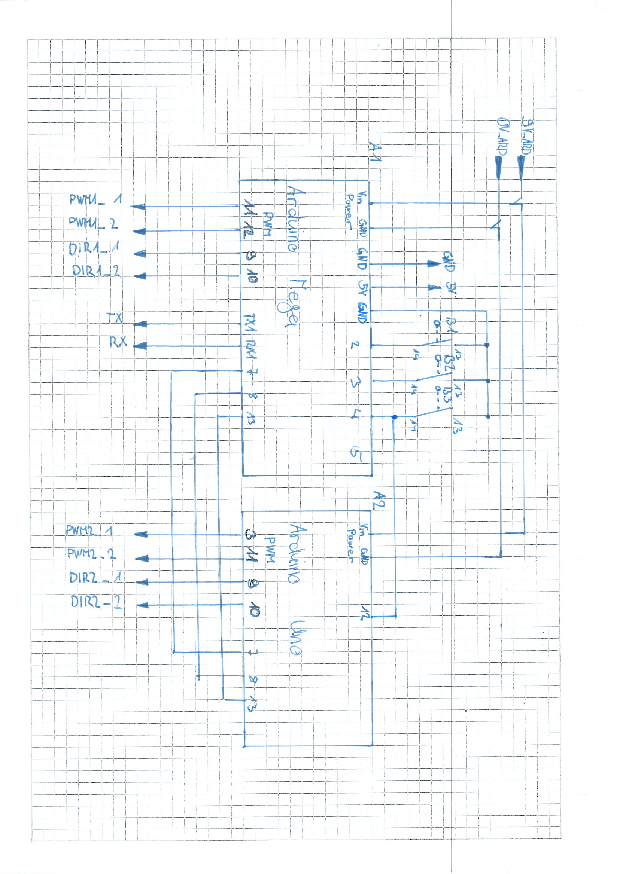
[picture p69: page 2]
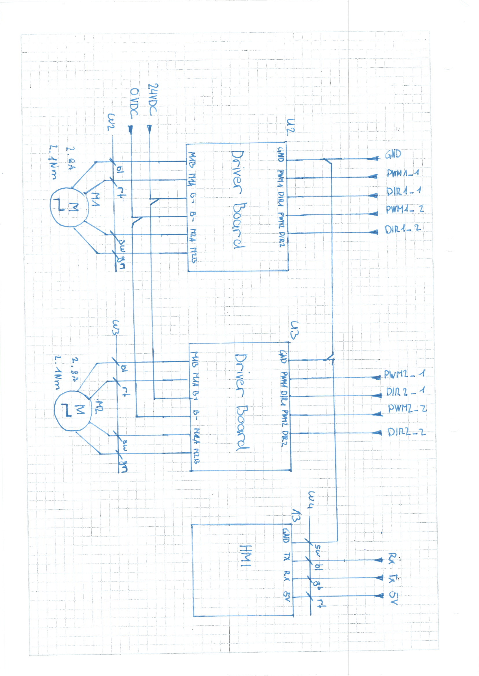
[picture p70: page 3]
