AkazeX/GEM/(list of files, cad)

Other CAD files:
60_Hardware/CAD/Baugruppe/Baugruppe1.iam
60_Hardware/CAD/Baugruppe/OldVersions/Baugruppe1.0010.iam
60_Hardware/CAD/Einzelteile/Bodenplatte.ipt
60_Hardware/CAD/Einzelteile/Drehstange.ipt
60_Hardware/CAD/Einzelteile/Flasche.ipt
60_Hardware/CAD/Einzelteile/Flaschenetikette.ipt
60_Hardware/CAD/Einzelteile/Glas und Flaschenboden.ipt
60_Hardware/CAD/Einzelteile/Glas.ipt
60_Hardware/CAD/Einzelteile/Glashalter.ipt
60_Hardware/CAD/Einzelteile/Hauptpfeiler.ipt
60_Hardware/CAD/Einzelteile/Hubstange Kurz.ipt
60_Hardware/CAD/Einzelteile/Hubstange Lang.ipt
60_Hardware/CAD/Einzelteile/Motor.ipt
60_Hardware/CAD/Einzelteile/Motorhalterung.ipt
60_Hardware/CAD/Einzelteile/OldVersions/Bodenplatte.0007.ipt
60_Hardware/CAD/Einzelteile/OldVersions/Drehstange.0005.ipt
60_Hardware/CAD/Einzelteile/OldVersions/Flasche.0005.ipt
60_Hardware/CAD/Einzelteile/OldVersions/Flaschenetikette.0001.ipt
60_Hardware/CAD/Einzelteile/OldVersions/Flaschenhalter links.0001.ipt
60_Hardware/CAD/Einzelteile/OldVersions/Flaschenhalter.0001.ipt
60_Hardware/CAD/Einzelteile/OldVersions/Flaschenhalterbügel.0001.ipt
60_Hardware/CAD/Einzelteile/OldVersions/Glas und Flaschenboden.0001.ipt
60_Hardware/CAD/Einzelteile/OldVersions/Glas.0001.ipt
60_Hardware/CAD/Einzelteile/OldVersions/Glashalter.0002.ipt
60_Hardware/CAD/Einzelteile/OldVersions/Halterungshauptplatte.0002.ipt
60_Hardware/CAD/Einzelteile/OldVersions/Hauptpfeiler.0008.ipt
60_Hardware/CAD/Einzelteile/OldVersions/Motor.0004.ipt
60_Hardware/CAD/Einzelteile/OldVersions/Motorhalterung.0001.ipt
60_Hardware/CAD/Einzelteile/OldVersions/Seil.0001.ipt
60_Hardware/CAD/Einzelteile/OldVersions/Stange FlascheGlas kurz.0005.ipt
60_Hardware/CAD/Einzelteile/OldVersions/Stange FlascheGlas.0006.ipt
60_Hardware/CAD/Einzelteile/OldVersions/Wasser.0002.ipt
60_Hardware/CAD/Einzelteile/Seil.ipt
60_Hardware/CAD/Einzelteile/Tragplatte.ipt
60_Hardware/CAD/Einzelteile/Wasser.ipt
