AkazeX/GEM/60_Hardware/Schema/Schema_GEM.pdf

1 | 2 | 3 | 4 | 5 | 6 | 7 | 8 | 9 | 10

# -Voltage regulator 9V

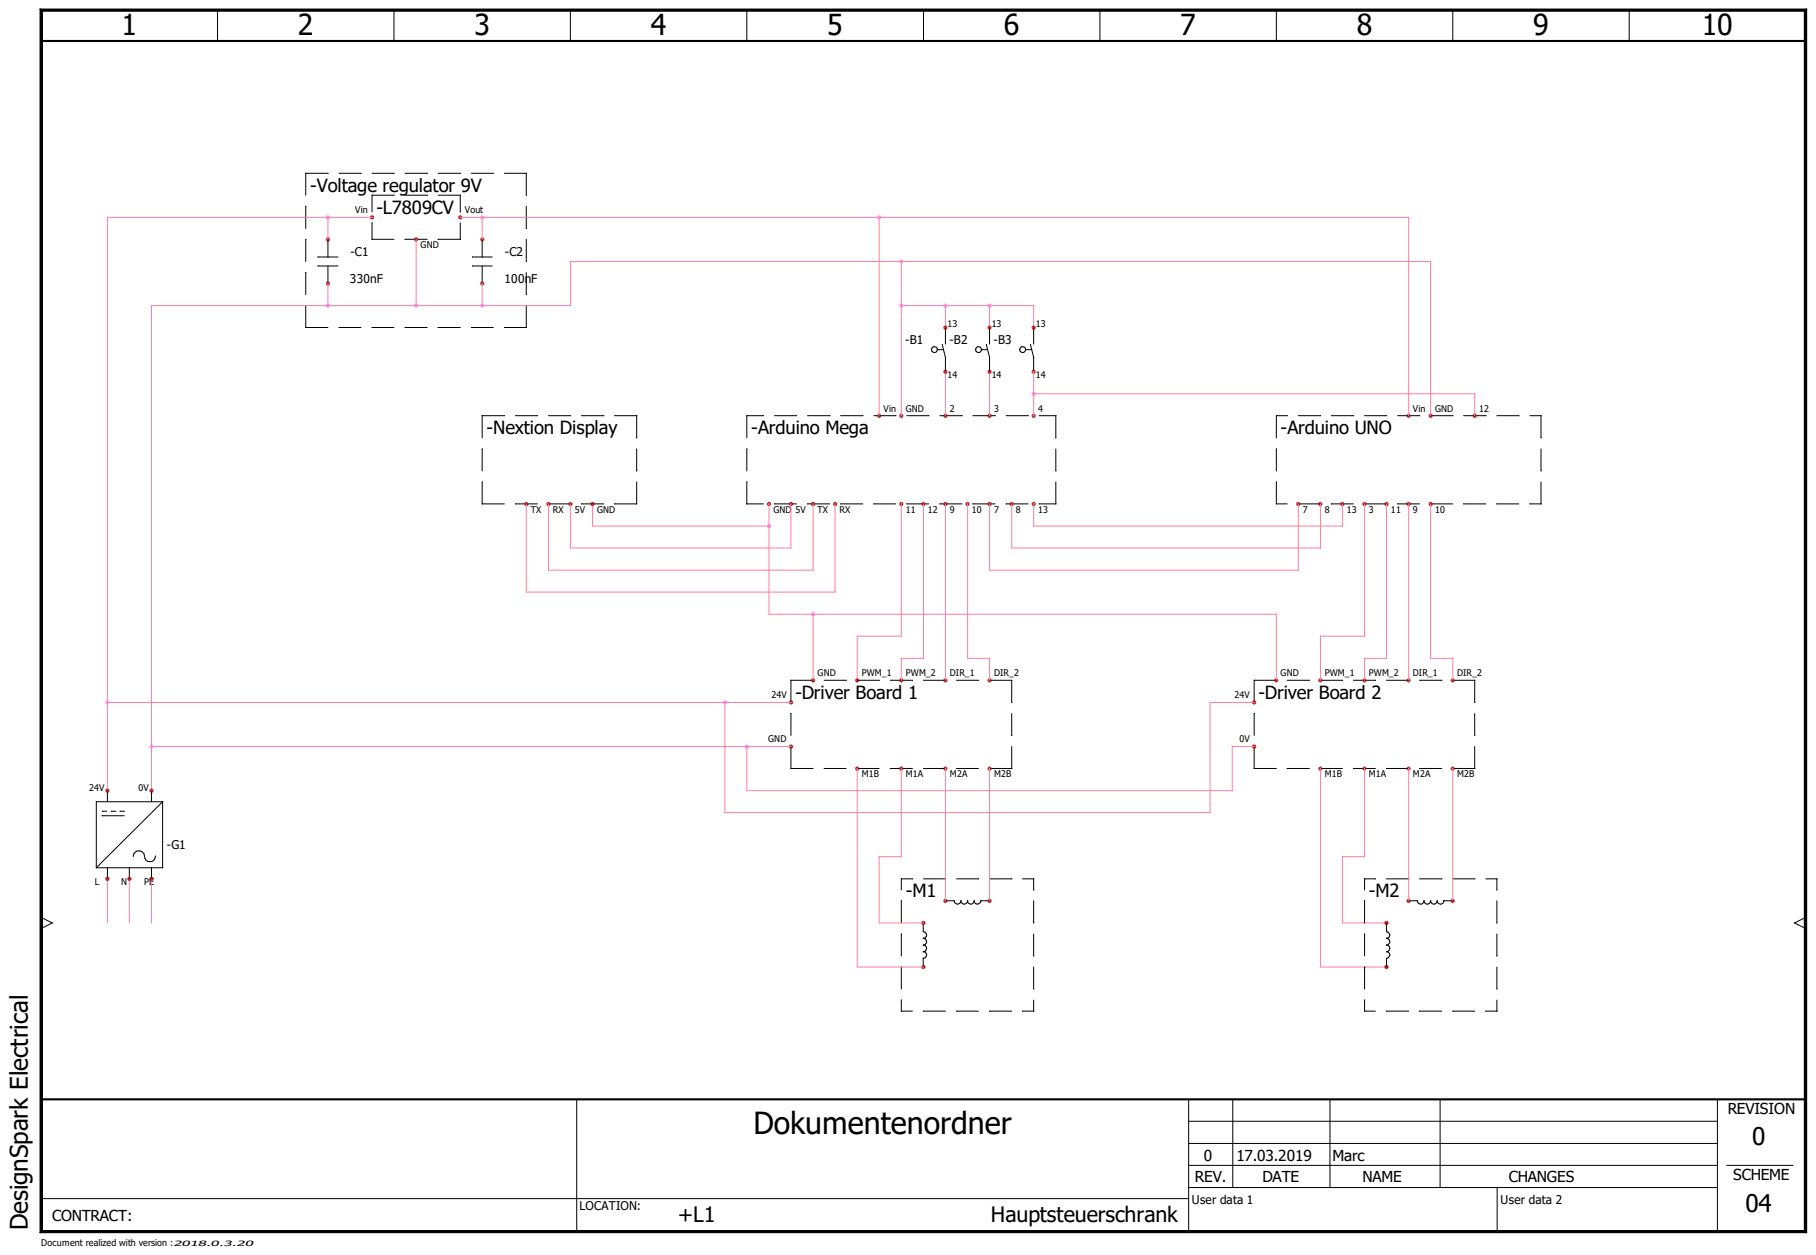
[picture p71: page 1]
Marc DesignSpark Electrical; Vin; Vout -L7809CV GND -C1; -Arduino Mega; -Arduino UNO; GND; -Nextion Display TX; -Driver Board 1; -Driver Board 2 GND; PWM_1; PWM_2; DIR_1; DIR_2; -M2 GND; 24V GND

Dokumentenordner | REVISION 0 SCHEME

REV. | DATE | NAME | CHANGES

2018.0.3.20 | Hauptsteuerschrank LOCATION: Document realized with version : CONTRACT:

User data 1 | User data 2 | 04 +L1
