AkazeX/GEM/50_Dokumentation/Abgabe/Anhang/5.WerkstattskizzenStücklisten/Zeichnungen/Bodenplatte.pdf

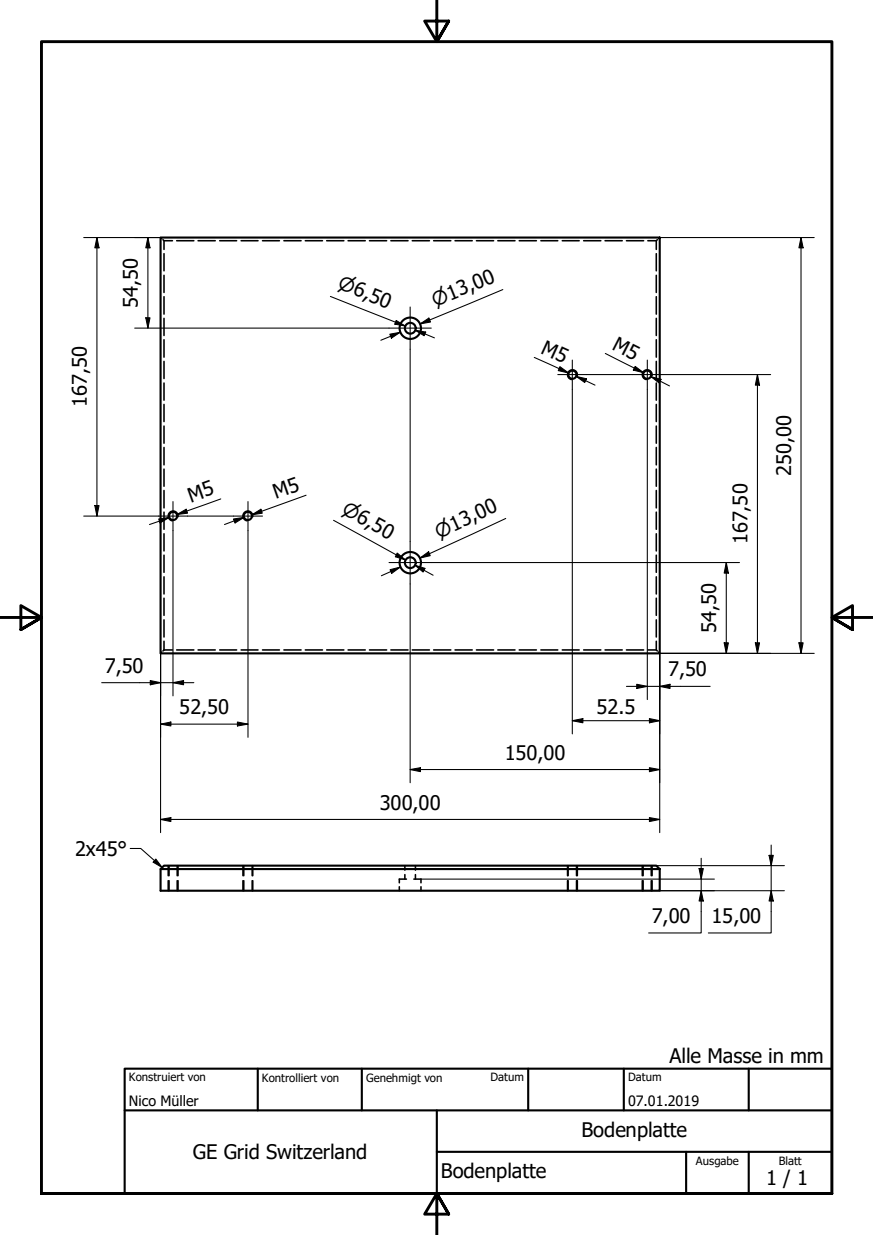
[picture p73: page 1]

Alle Masse in mm

Konstruiert von Nico Müller | Kontrolliert von | Genehmigt von Datum | Datum 07.01.2019

GE Grid Switzerland | Bodenplatte

Bodenplatte | Ausgabe | Blatt 1 / 1
