AkazeX/GEM/50_Dokumentation/Abgabe/Anhang/5.WerkstattskizzenStücklisten/Zeichnungen/Drehstange.pdf

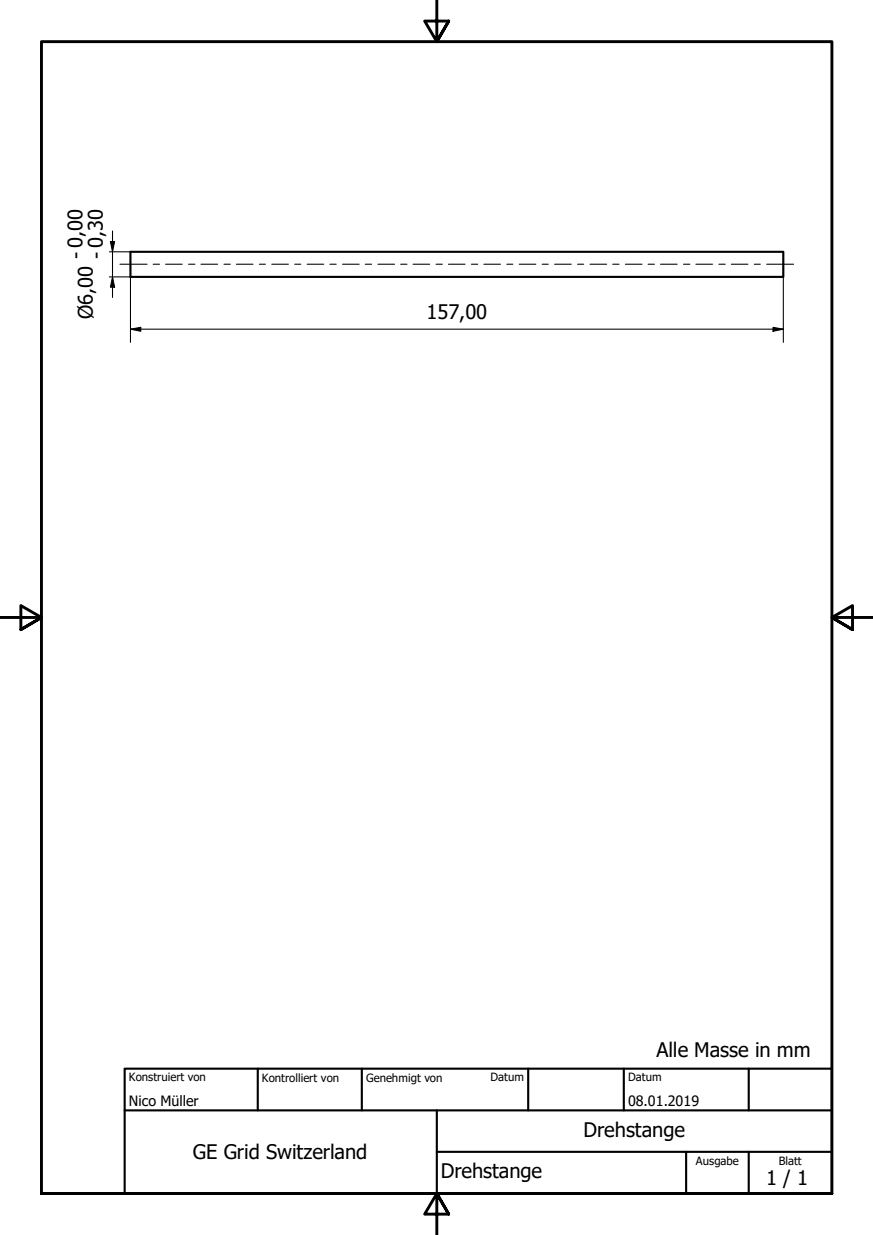
[picture p74: page 1]

Alle Masse in mm

Konstruiert von Nico Müller | Kontrolliert von | Genehmigt von Datum | Datum 08.01.2019

GE Grid Switzerland | Drehstange

Drehstange | Ausgabe | Blatt 1 / 1
