AkazeX/GEM/50_Dokumentation/Abgabe/Anhang/5.WerkstattskizzenStücklisten/Zeichnungen/FlaschenGlasboden.pdf

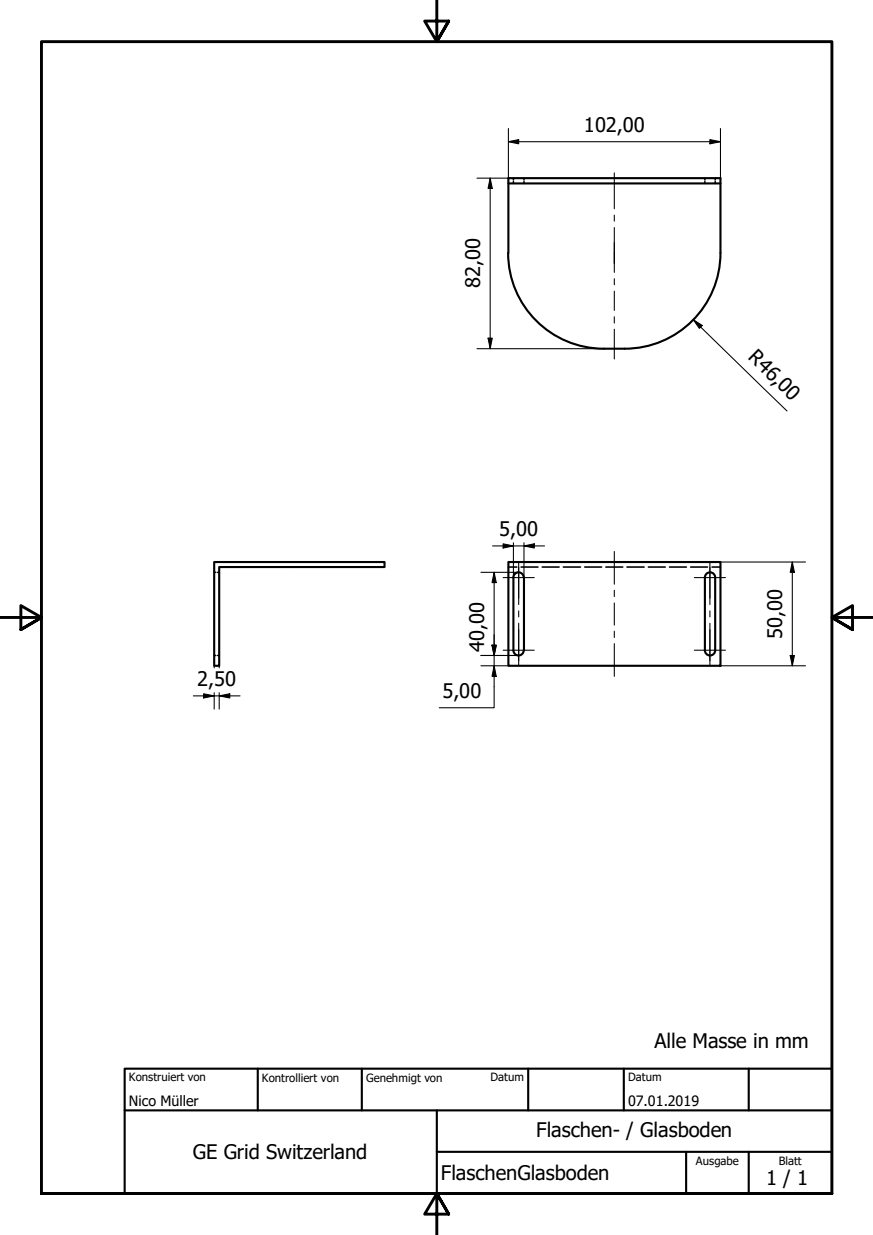
[picture p75: page 1]

Alle Masse in mm

Konstruiert von Nico Müller | Kontrolliert von | Genehmigt von Datum | Datum 07.01.2019

GE Grid Switzerland | Flaschen- / Glasboden

FlaschenGlasboden | Ausgabe | Blatt 1 / 1
