AkazeX/GEM/50_Dokumentation/Abgabe/Anhang/5.WerkstattskizzenStücklisten/Zeichnungen/Glashalter.pdf

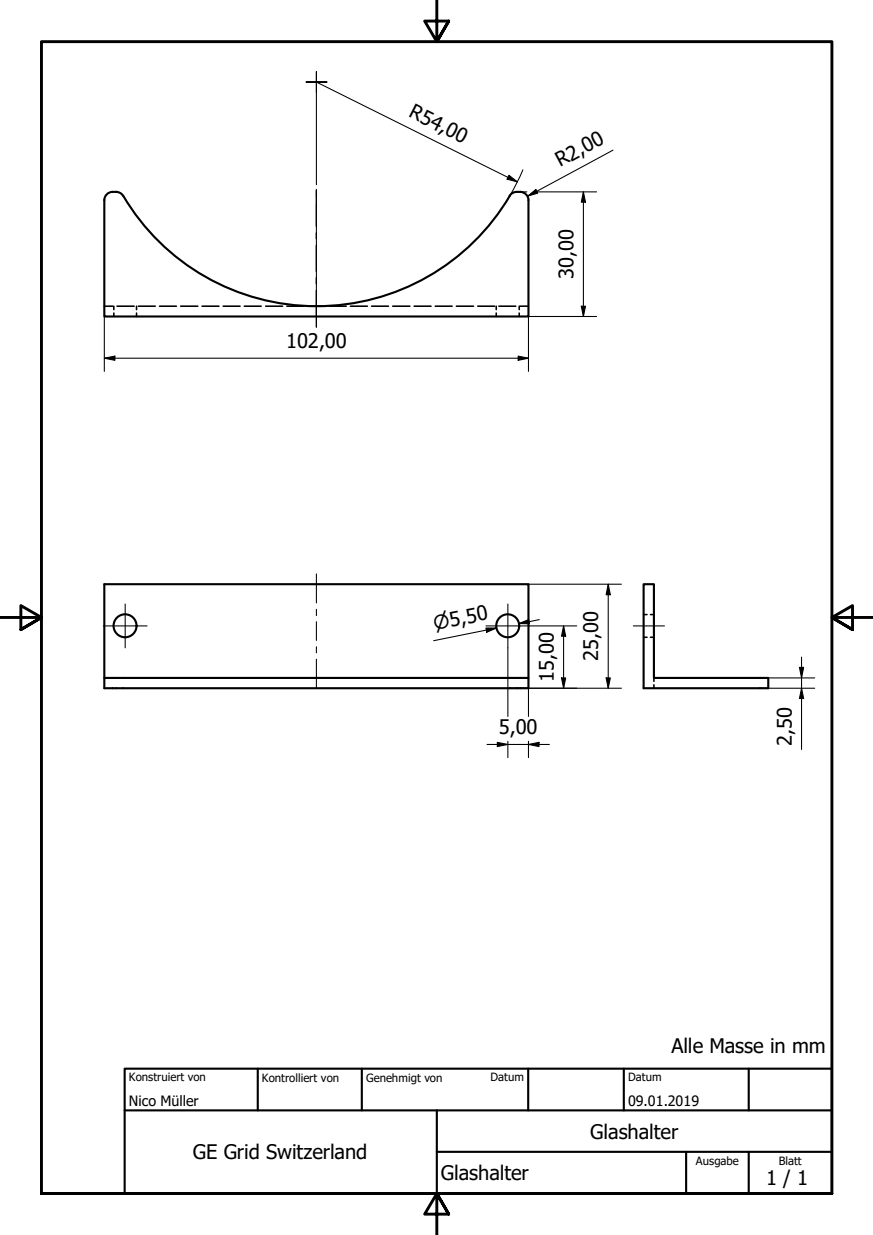
[picture p76: page 1]

Alle Masse in mm

Konstruiert von Nico Müller | Kontrolliert von | Genehmigt von Datum | Datum 09.01.2019

GE Grid Switzerland | Glashalter

Glashalter | Ausgabe | Blatt 1 / 1
