AkazeX/GEM/50_Dokumentation/Abgabe/Anhang/5.WerkstattskizzenStücklisten/Zeichnungen/Hauptpfeiler.pdf

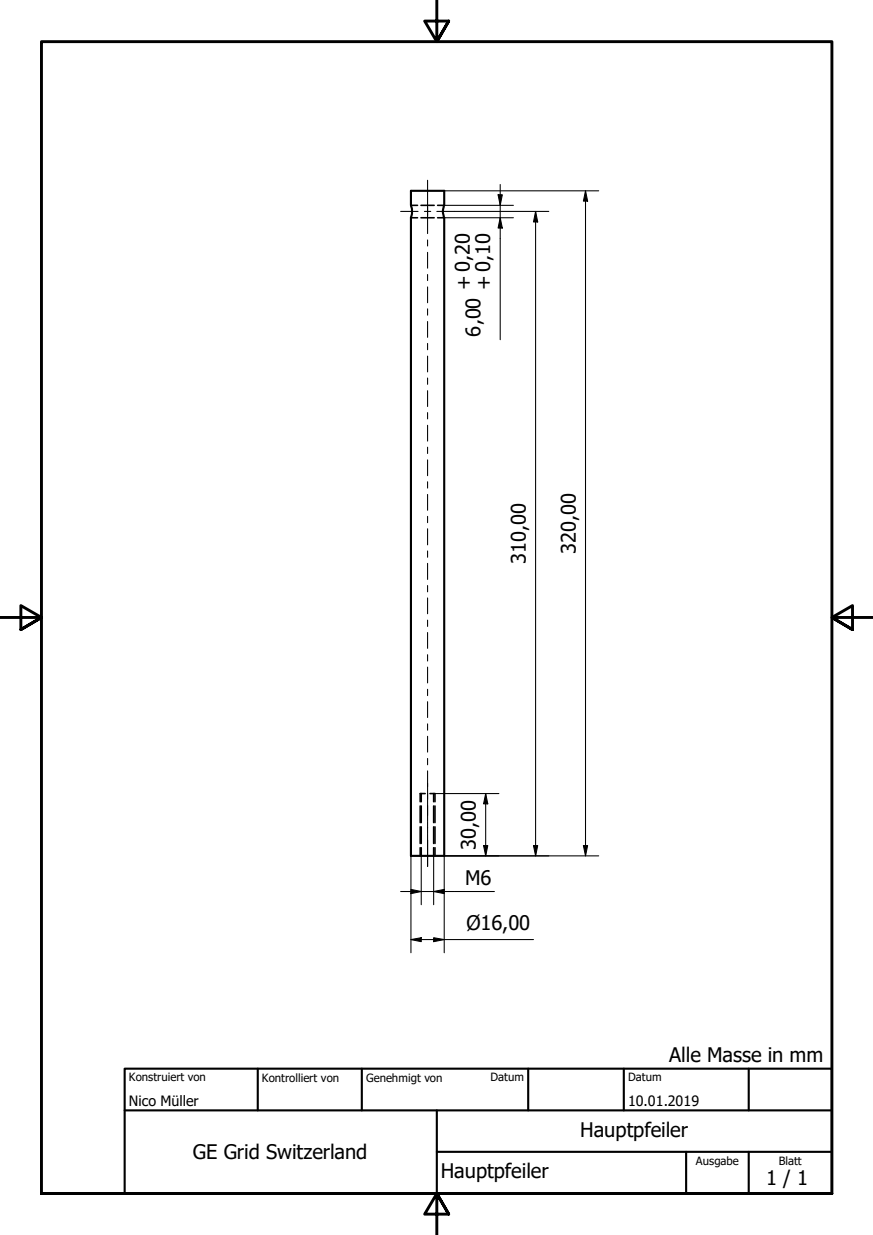
[picture p77: page 1]

Alle Masse in mm

Konstruiert von Nico Müller | Kontrolliert von | Genehmigt von Datum | Datum 10.01.2019

GE Grid Switzerland | Hauptpfeiler

Hauptpfeiler | Ausgabe | Blatt 1 / 1
