AkazeX/GEM/50_Dokumentation/Abgabe/Anhang/5.WerkstattskizzenStücklisten/Zeichnungen/Hubstange Kurz.pdf

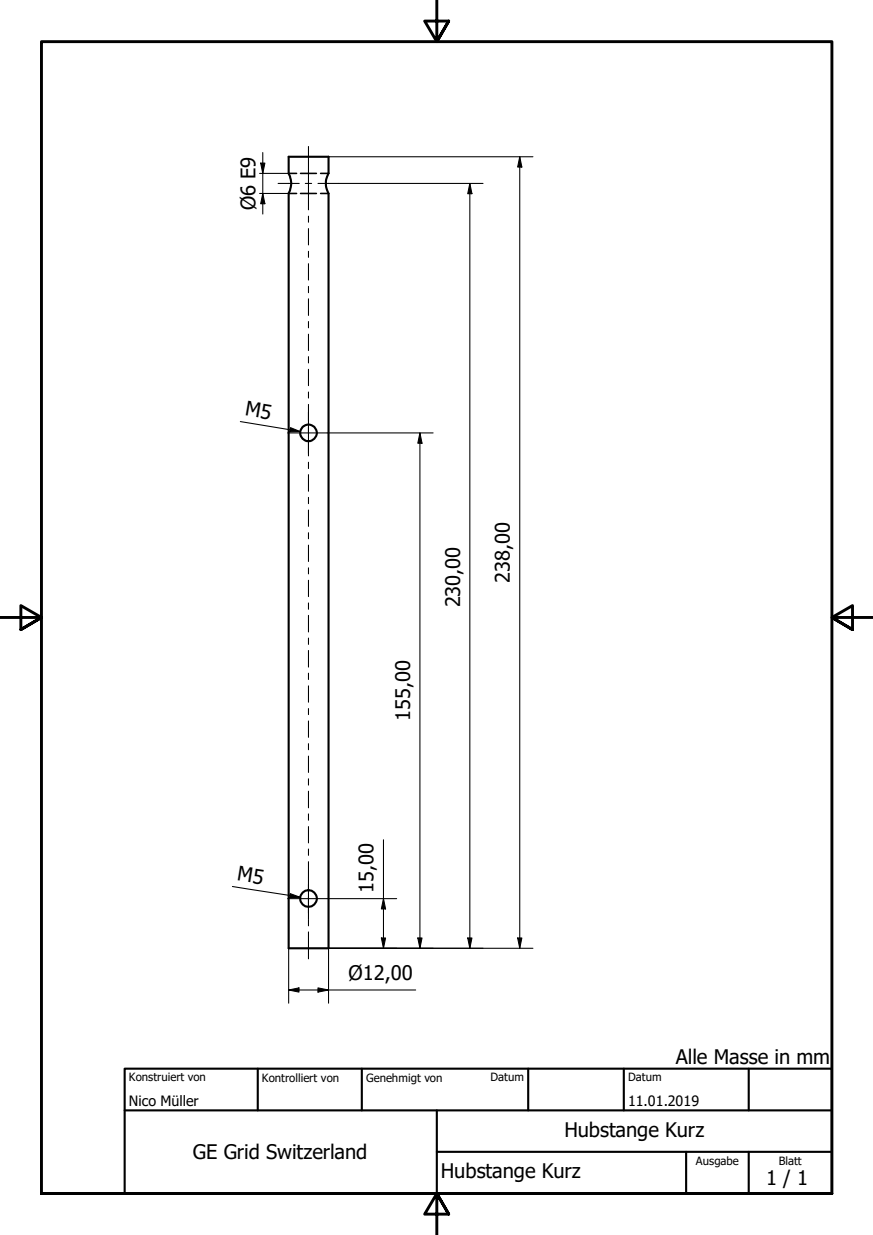
[picture p78: page 1]

Alle Masse in mm

Konstruiert von Nico Müller | Kontrolliert von | Genehmigt von Datum | Datum 11.01.2019

GE Grid Switzerland | Hubstange Kurz

Hubstange Kurz | Ausgabe | Blatt 1 / 1
