AkazeX/GEM/50_Dokumentation/Abgabe/Anhang/5.WerkstattskizzenStücklisten/Zeichnungen/Hubstange Lang.pdf

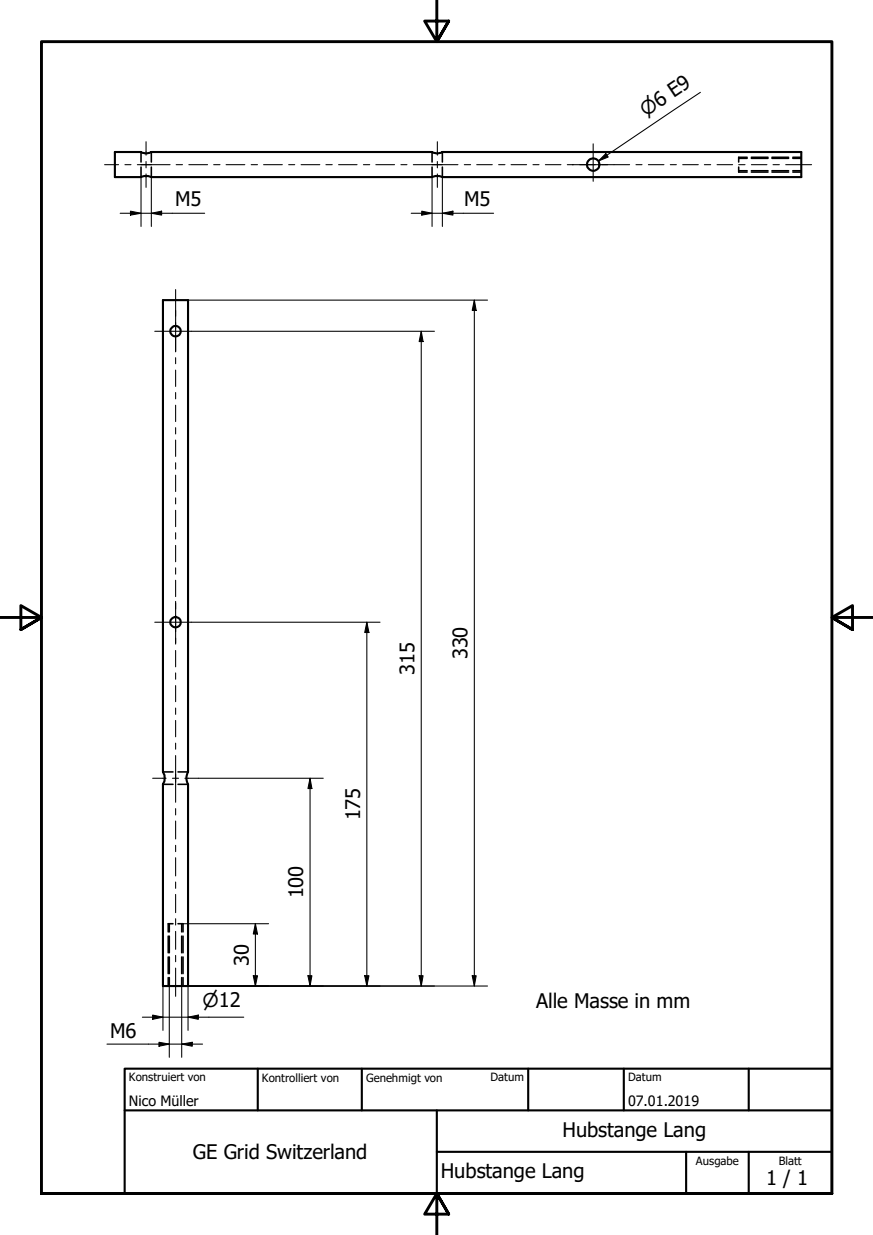
[picture p79: page 1]

Alle Masse in mm

Konstruiert von Nico Müller | Kontrolliert von | Genehmigt von Datum | Datum 07.01.2019

GE Grid Switzerland | Hubstange Lang

Hubstange Lang | Ausgabe | Blatt 1 / 1
