AkazeX/GEM/50_Dokumentation/Abgabe/Anhang/5.WerkstattskizzenStücklisten/Zeichnungen/Tragplatte.pdf

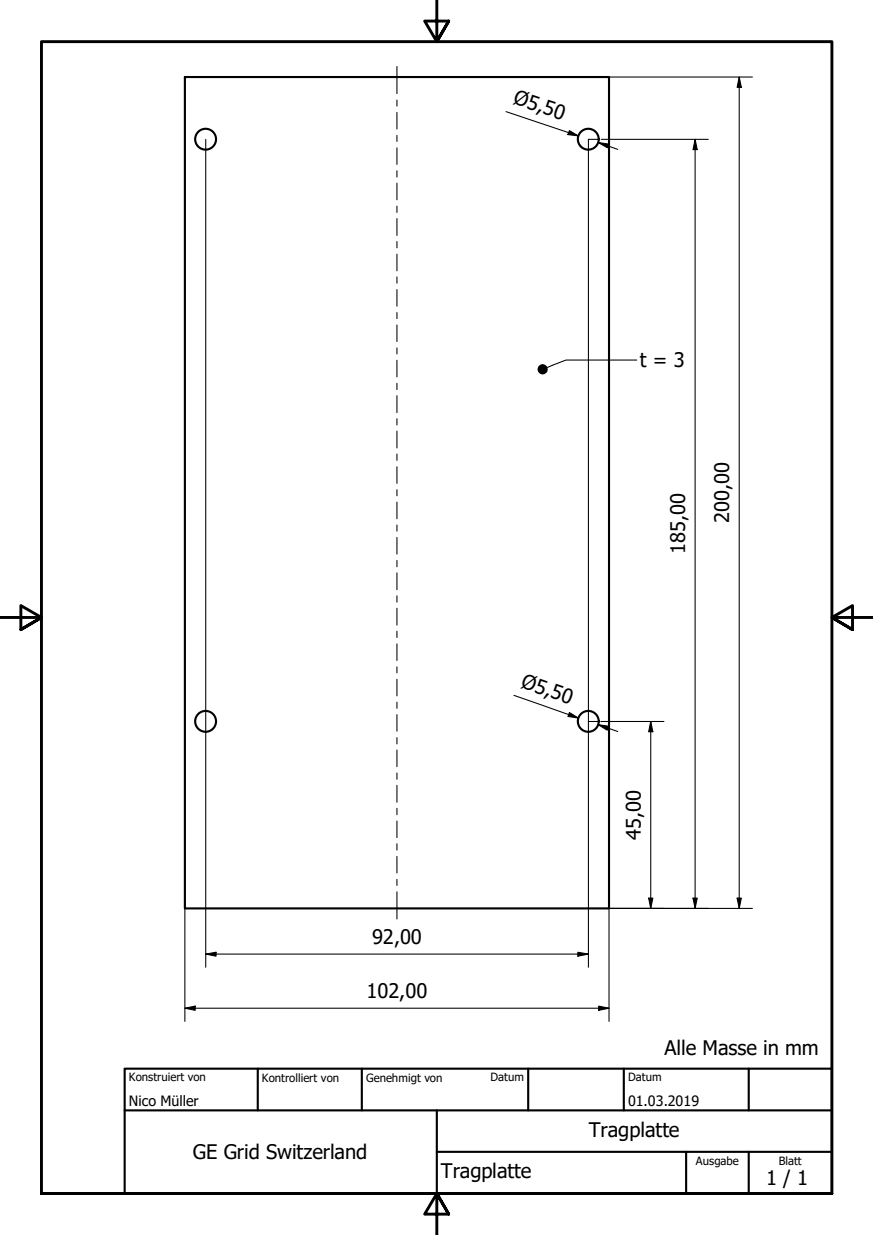
[picture p80: page 1]

Alle Masse in mm

Konstruiert von Nico Müller | Kontrolliert von | Genehmigt von Datum | Datum 01.03.2019

GE Grid Switzerland | Tragplatte

Tragplatte | Ausgabe | Blatt 1 / 1
