AkazeX/GEM/(commit log)

2018-09-21 Teilfunktionen skizzen und varianten
2018-10-15 Halterung für Glas und Flasche verbressert.
2018-10-28 Zeitplanung hinzugefügt
    [Zeitplanung.xlsx]
2018-10-28 Zeitplanung verbessert
    [Zeitplanung.xlsx]
2018-11-28 Programm Update OperatingMode
    [Zeitplanung.xlsx, Zeitplanung_V2.xlsx]
2018-12-05 Zeitplan verschoben + arbetisjournal
    [Zeitplanung.xlsx, Zeitplanung_V2.xlsx]
2018-12-17 state of the project
    [Zeitplanung_V2.xlsx]
2019-01-10 Software update
    [Zeitplanung_V2.xlsx]
2019-01-23 Software und HMI update
    [ObjectIDs.xlsx]
2019-01-25 Motor abstimmung
2019-02-21 Dokumentation erweitert
    - Materialliste hinzugefügt (nur mechanische Teile)
    - CAD Beschreibung hinzugefügt (noch nicht ganz fertig)
2019-02-22 Grafect update und Doku
2019-02-23 software update und umstrukturierung
2019-02-23 hmi update
    [ObjectIDs.xlsx]
2019-02-25 Doku Display added
    [ObjectIDs.xlsx]
2019-02-26 Anhang Doku
    [Arbeitsjournal.xlsx, Zeitplanung_V2.xlsx]
2019-02-28 doku, arbeitsjournal
    [Arbeitsjournal.xlsx]
2019-02-28 update ahang ond doku
    [Arbeitsjournal.xlsx]
2019-03-01 Zeichnungen hinzugefügt, Rechtschreibefehler korrigiert
    Zeichnungen hinzugefügt, CAD Modell hinzugefügt, viele Rechtschreibfehler korrigiert. Analge statt Anlage war übrigens auch unter den Fehlern.
    [Baugruppe1.0010.iam, Baugruppe1.iam, Bodenplatte.0007.ipt, Bodenplatte.ipt, Drehstange.0005.ipt, Drehstange.ipt, Flasche.0005.ipt, Flasche.ipt]
2019-03-01 Rechtschreibfehler in Dokumenten korrigiert, Stücklistentitle schöner gemacht
    [Arbeitsjournal.xlsx]
2019-03-01 Arbeitsjournal Update & Rechtschreibkorrektur
    [Arbeitsjournal.xlsx]
2019-03-01 Doku update
    [Arbeitsjournal.xlsx, Zeitplanung_V2.xlsx]
2019-03-01 Projekt Abschluss
    [Arbeitsjournal.xlsx]
2019-03-13 Powerpoint Layout
2019-03-17 Ist-Zeitplan eingefügt, Präsentation erweitert
    [Ist-Zeit.xlsx]
2019-03-20 update software
    [ObjectIDs.xlsx]
